mschwabmd/UMBC_DPLX_SPARK_2018/SPARK CAD Files/DPLX_A001_revE_Electrode_assm.SLDASM

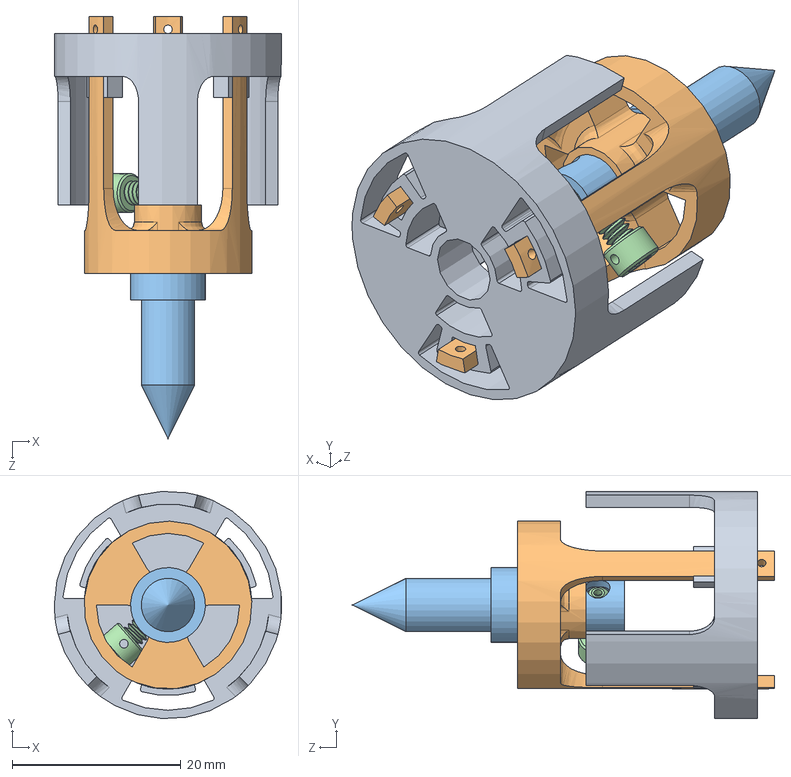
[picture p1: CAD file, 2018-07-30]
SPARK CAD Files/DPLX_A001_revE_Electrode_assm.SLDASM
27.0 x 27.0 x 50.1 mm
DPLX_P004_revD_large_outside_baffle
DPLX_P003_revB_small_inside_baffle
DPLX_P001_Electrode
DPLX_P006_BRASS SOCKET HEAD CAP SCREW
