mschwabmd/UMBC_DPLX_SPARK_2018/CAD Step Files/DPLX_A002_Lab_Version.stp

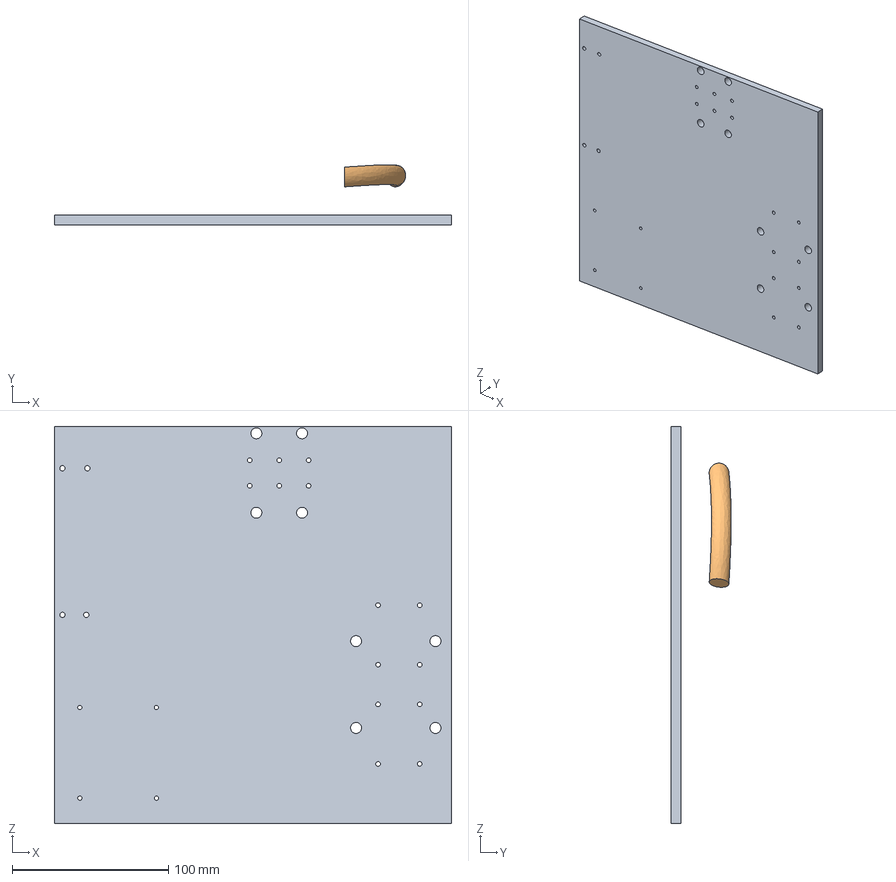
[picture p2: CAD file, 2018-07-31]
CAD Step Files/DPLX_A002_Lab_Version.stp
254.0 x 38.6 x 254.0 mm
DPLX_P013_Lab_Baseplate
Wire3
