mschwabmd/UMBC_DPLX_SPARK_2018/SPARK CAD Files/DPLX_P005_quartz_tube.SLDPRT

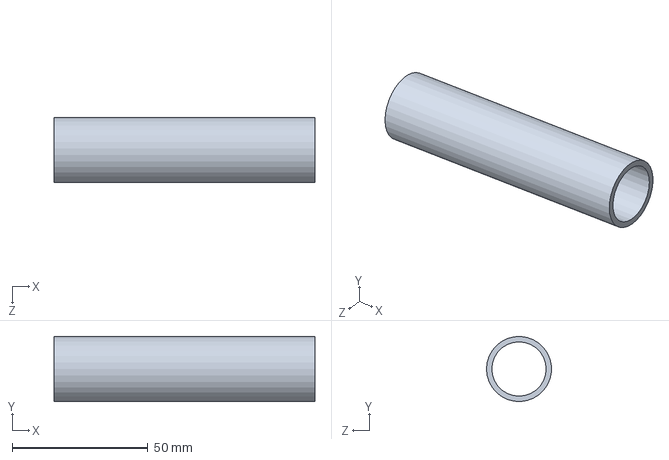
[picture p3: CAD file, 2018-07-30]
SPARK CAD Files/DPLX_P005_quartz_tube.SLDPRT
96.2 x 24.0 x 24.0 mm
