mschwabmd/UMBC_DPLX_SPARK_2018/CAD Step Files/DPLX_P019_Camera Shroud_RevA.stp

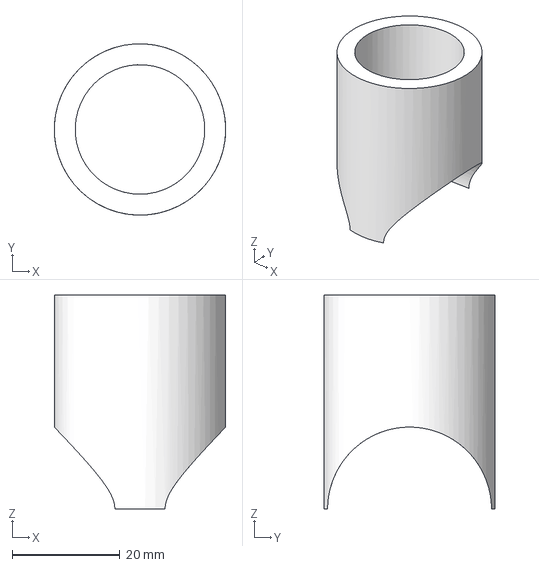
[picture p4: CAD file, 2018-07-31]
CAD Step Files/DPLX_P019_Camera Shroud_RevA.stp
31.7 x 31.7 x 39.6 mm
