mschwabmd/UMBC_DPLX_SPARK_2018/SPARK CAD Files/DPLX_P004_revD_large_outside_baffle.SLDPRT

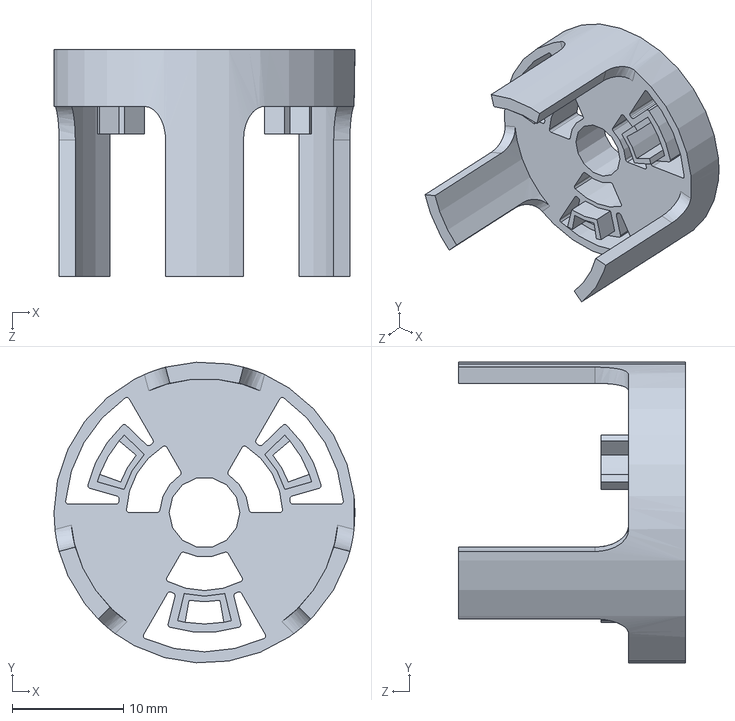
[picture p5: CAD file, 2018-07-30]
SPARK CAD Files/DPLX_P004_revD_large_outside_baffle.SLDPRT
27.0 x 27.0 x 20.3 mm
