mschwabmd/UMBC_DPLX_SPARK_2018/CAD Step Files/DPLX_P023 Spark Gap Shielding Bottom.stp

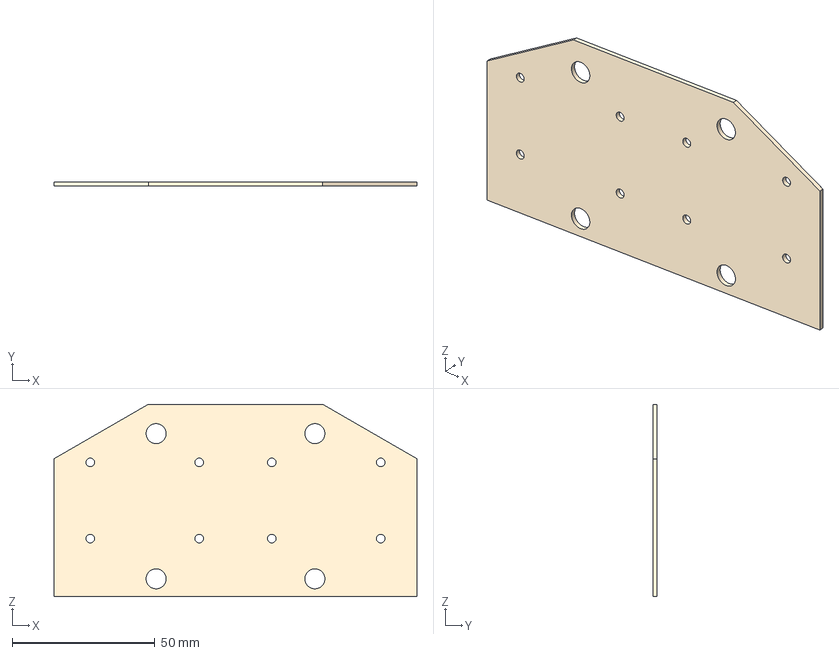
[picture p6: CAD file, 2018-07-31]
CAD Step Files/DPLX_P023 Spark Gap Shielding Bottom.stp
127.0 x 1.52 x 67.3 mm
