mschwabmd/UMBC_DPLX_SPARK_2018/SPARK CAD Files/DPLX_P020_Camera Shroud Base_RevB.stp

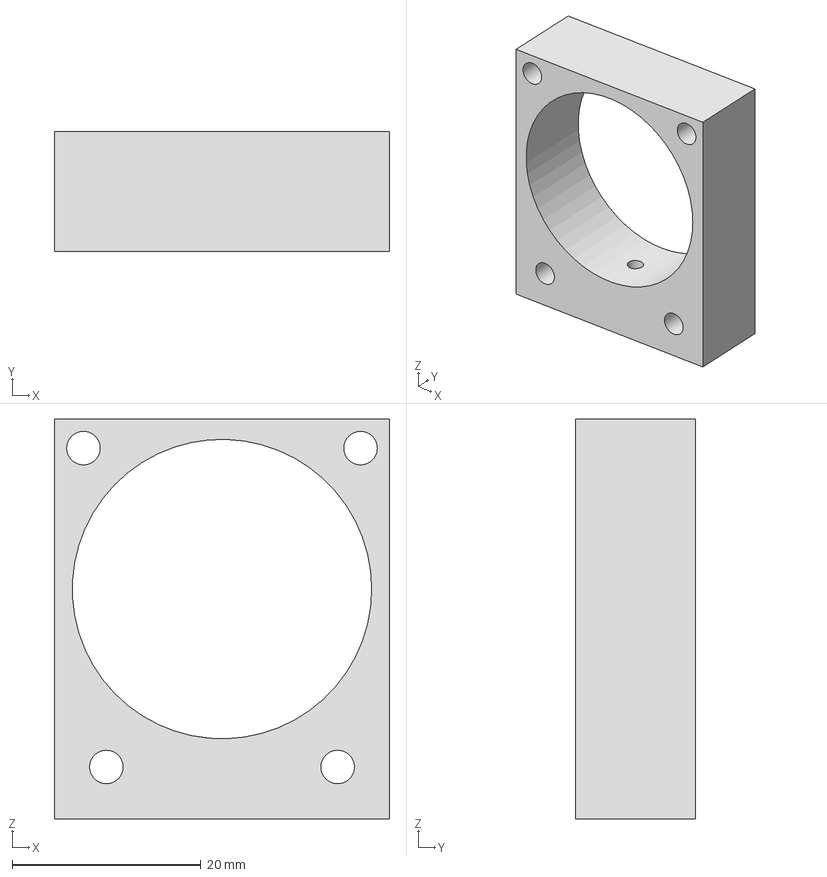
[picture p7: CAD file, 2018-07-30]
SPARK CAD Files/DPLX_P020_Camera Shroud Base_RevB.stp
35.6 x 12.7 x 42.4 mm
