mschwabmd/UMBC_DPLX_SPARK_2018/CAD Step Files/Pin dowel .0625^225-00000-000_CD.stp

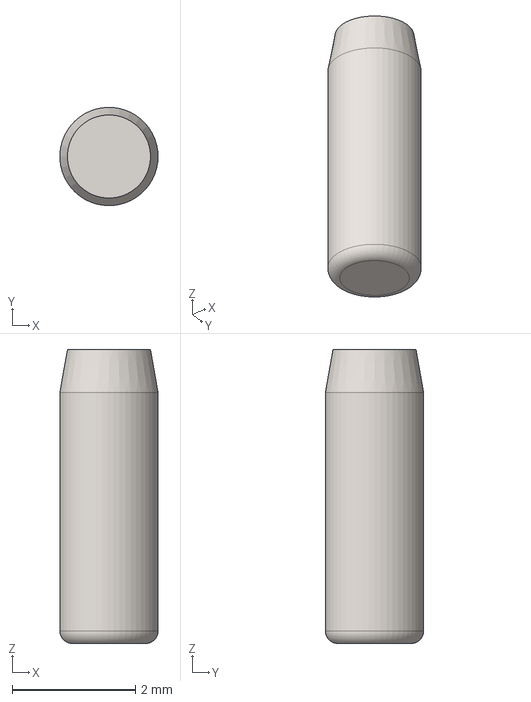
[picture p8: CAD file, 2018-07-31]
CAD Step Files/Pin dowel .0625^225-00000-000_CD.stp
1.59 x 1.59 x 4.76 mm
