mschwabmd/UMBC_DPLX_SPARK_2018/SPARK CAD Files/Ocean Optics Flame.stp

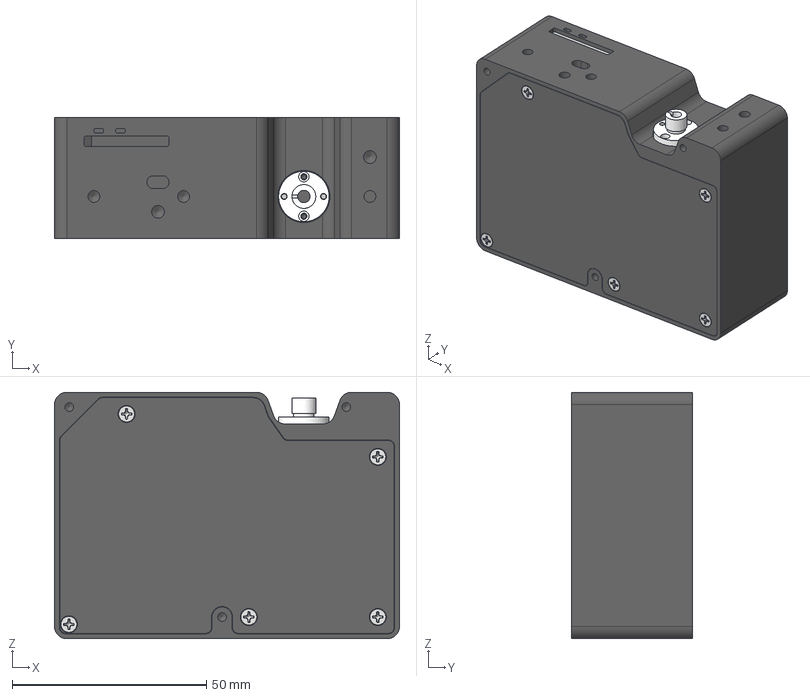
[picture p9: CAD file, 2018-07-30]
SPARK CAD Files/Ocean Optics Flame.stp
88.9 x 31.1 x 63.5 mm
Bench^225-00000-000_CD
Connector^225-00000-000_CD
Pin dowel .0625^225-00000-000_CD x 2
Cover Top^225-00000-000_CD
Cover Bottom^225-00000-000_CD
No 2 Screw^225-00000-000_CD x 11
