mschwabmd/UMBC_DPLX_SPARK_2018/CAD Step Files/Pi Wire.stp

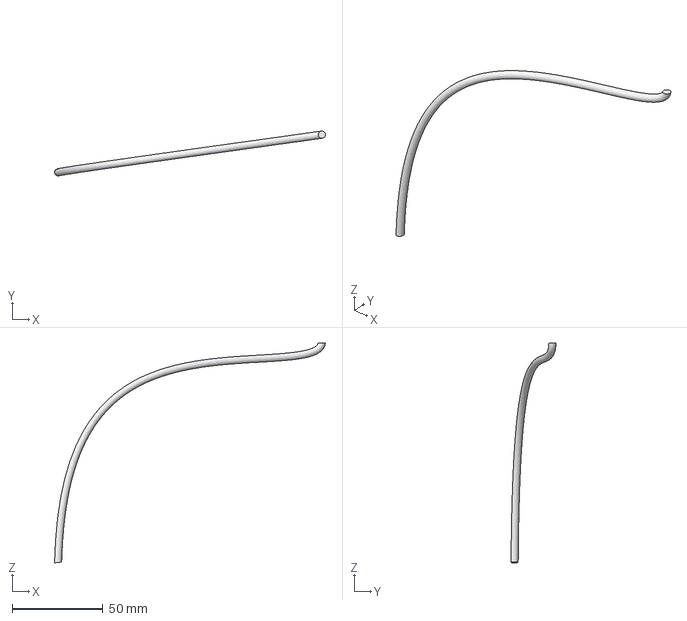
[picture p10: CAD file, 2018-07-31]
CAD Step Files/Pi Wire.stp
149.5 x 24.8 x 121.2 mm
