mschwabmd/UMBC_DPLX_SPARK_2018/CAD Step Files/DPLX_P037 USB.stp

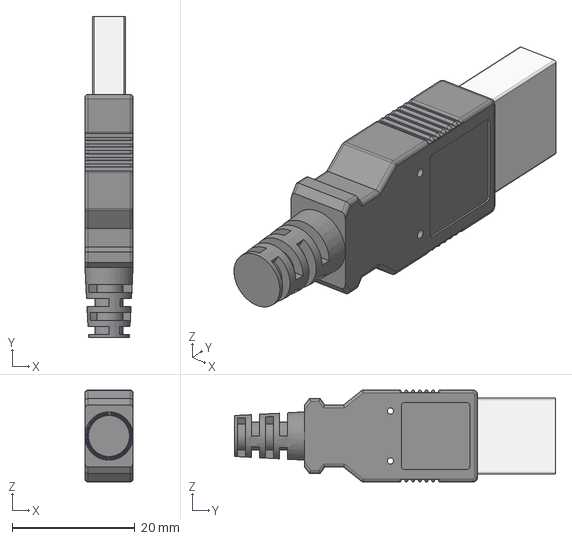
[picture p11: CAD file, 2018-07-31]
CAD Step Files/DPLX_P037 USB.stp
7.87 x 52.3 x 15.0 mm
