mschwabmd/UMBC_DPLX_SPARK_2018/CAD Step Files/DPLX_A005_Spark_Gap_Lab.stp

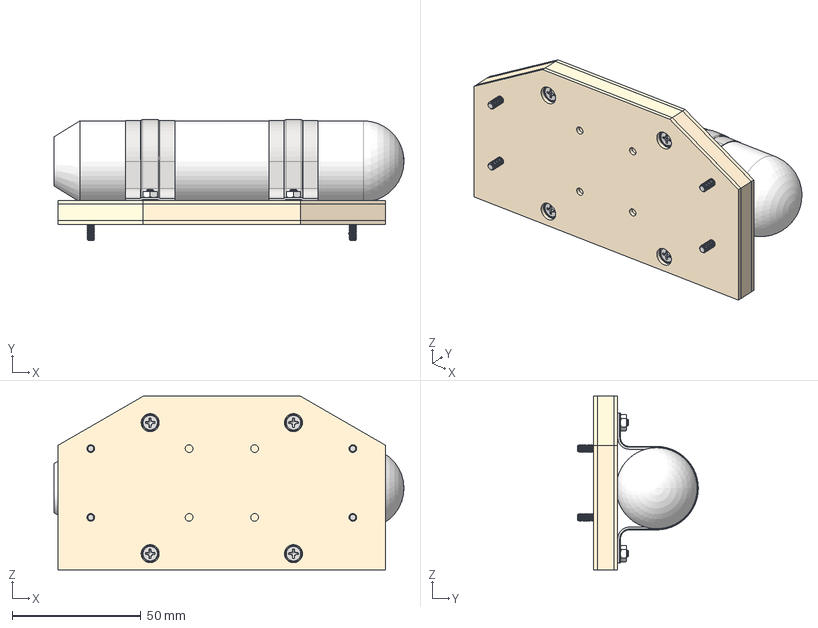
[picture p12: CAD file, 2018-07-31]
CAD Step Files/DPLX_A005_Spark_Gap_Lab.stp
135.7 x 46.8 x 67.3 mm
DPLX_P023 Spark Gap Shielding Bottom
DPLX_P022 Spark Gap Shielding Top
DPLX_P035 Spark Gap Shielding Middle
92010A787_PASSIVATED 18-8 SS PHILLIPS FLAT HEAD SCREW x 4
92010A122_METRIC 18-8 SS FLAT HEAD PHIL MACHINE SCREW x 4
9429T360_STEEL CLAMP x 2
DPLX_P025_Quartz_Tube
DPLX_P007_Wire_Mesh_Sleeve_Spark_Gap
DPLX_P033_SG_Viton rubber Cover
DPLX_P015_Foil_Wrap_SG
DPLX_P001_Electrode x 2
DPLX_P006_BRASS SOCKET HEAD CAP SCREW x 2
DPLX_P003_small_inside_baffle_RevB x 2
DPLX_P004_revD_large_outside_baffle x 2
91828A211_TYPE 18-8 STAINLESS STEEL HEX NUT x 4
DPLX_P010_Wire_Mesh_reducer_Spark_Gap
