mschwabmd/UMBC_DPLX_SPARK_2018/SPARK CAD Files/DPLX_P003_revC_small_inside_baffle.SLDPRT

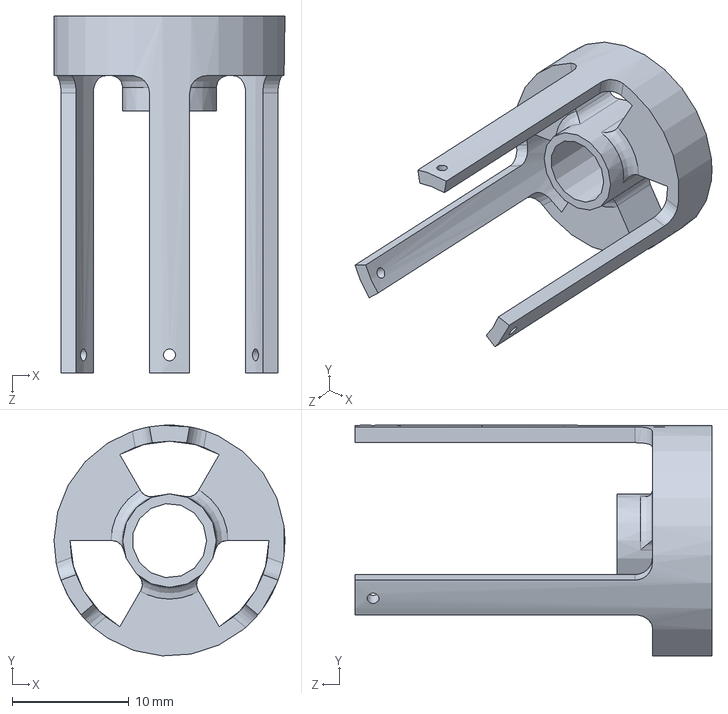
[picture p13: CAD file, 2018-07-30]
SPARK CAD Files/DPLX_P003_revC_small_inside_baffle.SLDPRT
19.8 x 19.7 x 30.5 mm
