mschwabmd/UMBC_DPLX_SPARK_2018/SPARK CAD Files/DPLX_P001_Electrode.SLDPRT

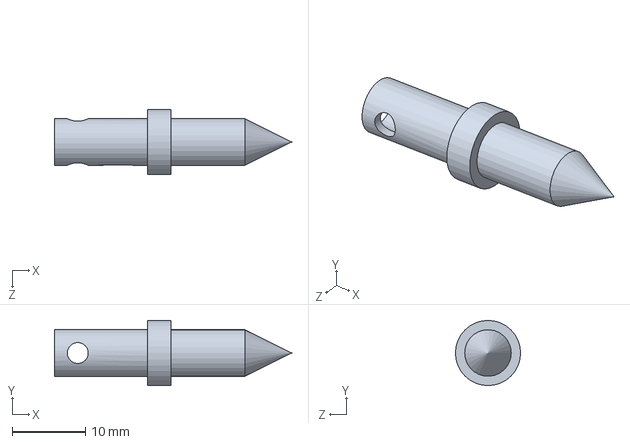
[picture p15: CAD file, 2018-07-30]
SPARK CAD Files/DPLX_P001_Electrode.SLDPRT
32.3 x 8.89 x 8.89 mm
