mschwabmd/UMBC_DPLX_SPARK_2018/CAD Step Files/DPLX_P032_VIPE Insulation Middle.stp

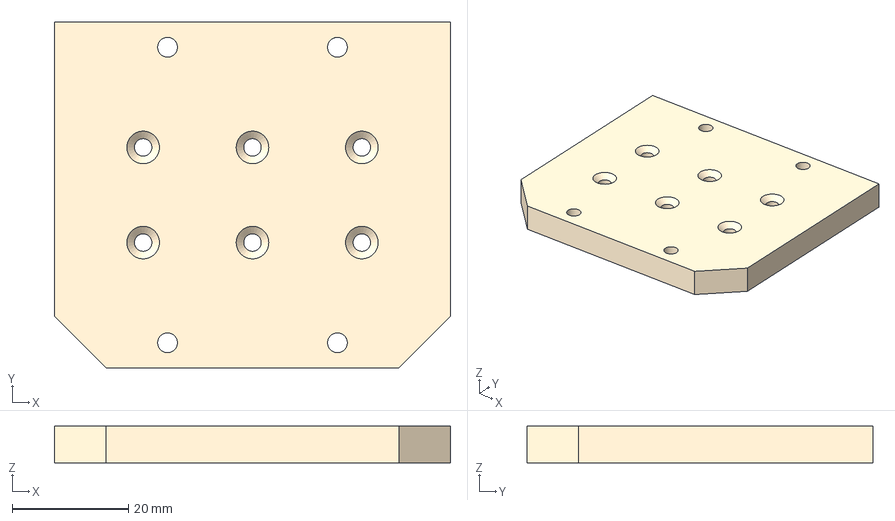
[picture p16: CAD file, 2018-07-31]
CAD Step Files/DPLX_P032_VIPE Insulation Middle.stp
68.1 x 59.5 x 6.35 mm
