mschwabmd/UMBC_DPLX_SPARK_2018/CAD Step Files/DPLX_P026_VIPE _Transformer.stp

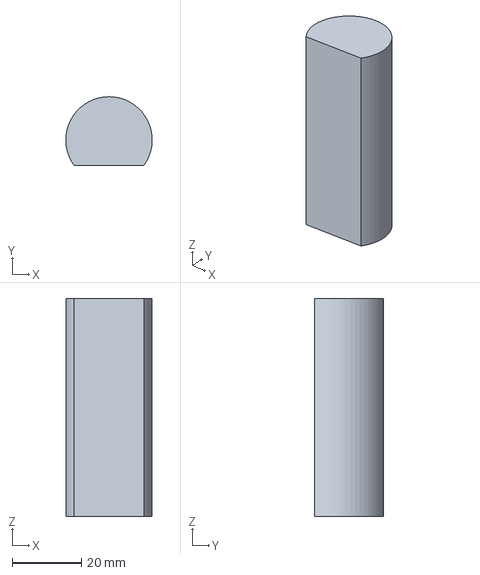
[picture p17: CAD file, 2018-07-31]
CAD Step Files/DPLX_P026_VIPE _Transformer.stp
25.0 x 19.8 x 63.0 mm
