mschwabmd/UMBC_DPLX_SPARK_2018/CAD Step Files/Cover Bottom^225-00000-000_CD.stp

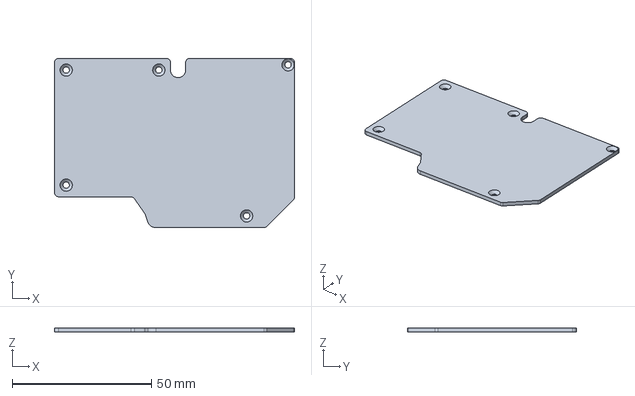
[picture p19: CAD file, 2018-07-31]
CAD Step Files/Cover Bottom^225-00000-000_CD.stp
86.1 x 60.7 x 1.52 mm
