mschwabmd/UMBC_DPLX_SPARK_2018/CAD Step Files/DPLX_P008_Wire_Mesh_Sleeve_Trans.stp

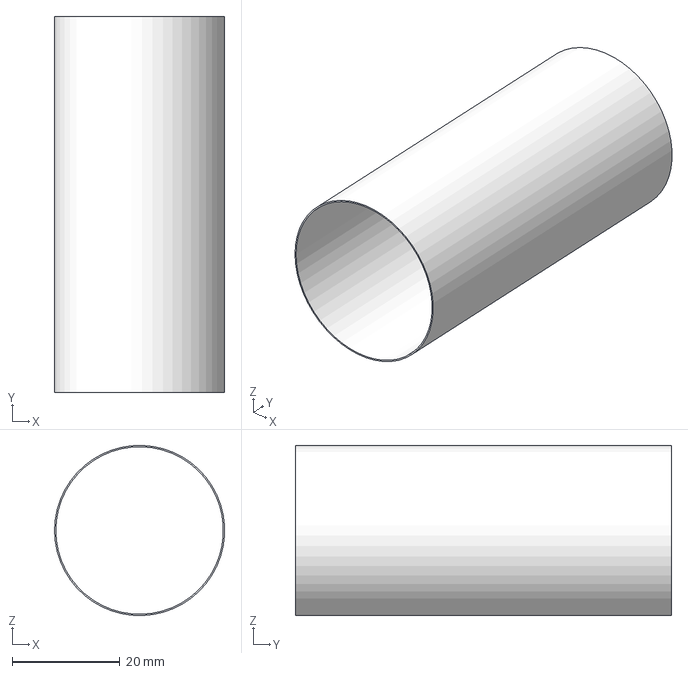
[picture p20: CAD file, 2018-07-31]
CAD Step Files/DPLX_P008_Wire_Mesh_Sleeve_Trans.stp
31.6 x 70.0 x 31.6 mm
