mschwabmd/UMBC_DPLX_SPARK_2018/CAD Step Files/DPLX_P013_Lab_Baseplate.stp

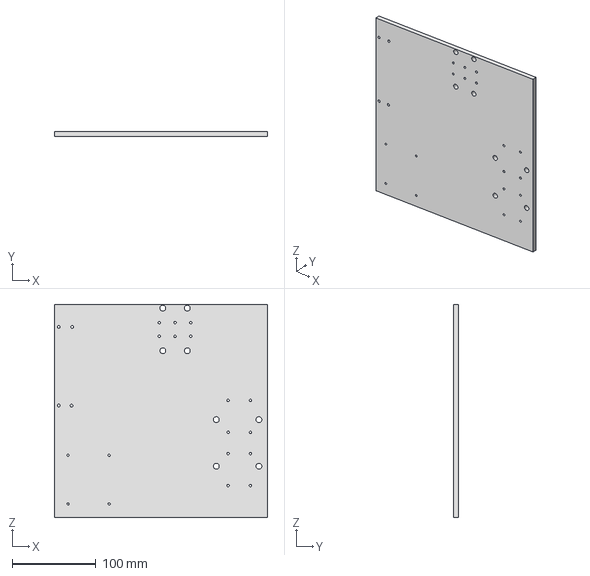
[picture p21: CAD file, 2018-07-31]
CAD Step Files/DPLX_P013_Lab_Baseplate.stp
254.0 x 6.35 x 254.0 mm
