mschwabmd/UMBC_DPLX_SPARK_2018/CAD Step Files/DPLX_P034_RPS VIPE Viton Insualtion.stp

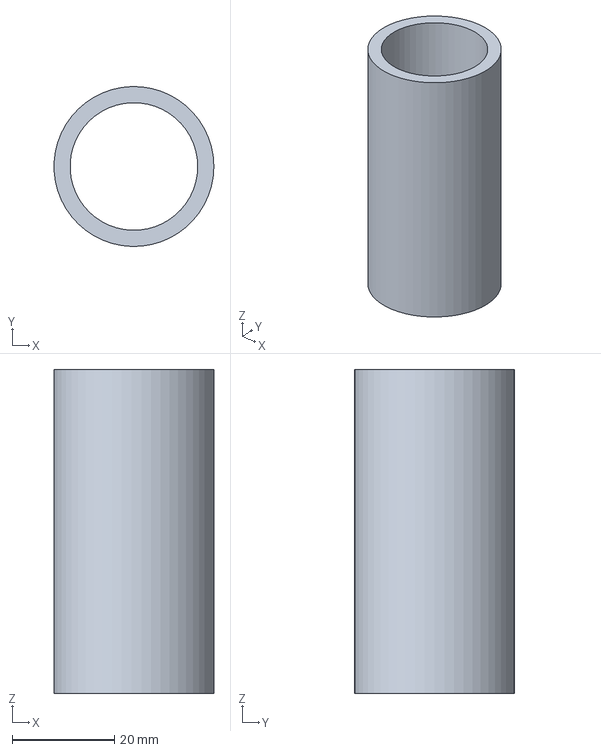
[picture p22: CAD file, 2018-07-31]
CAD Step Files/DPLX_P034_RPS VIPE Viton Insualtion.stp
31.3 x 31.3 x 63.5 mm
