mschwabmd/UMBC_DPLX_SPARK_2018/CAD Step Files/Wire to Spark Gap.stp

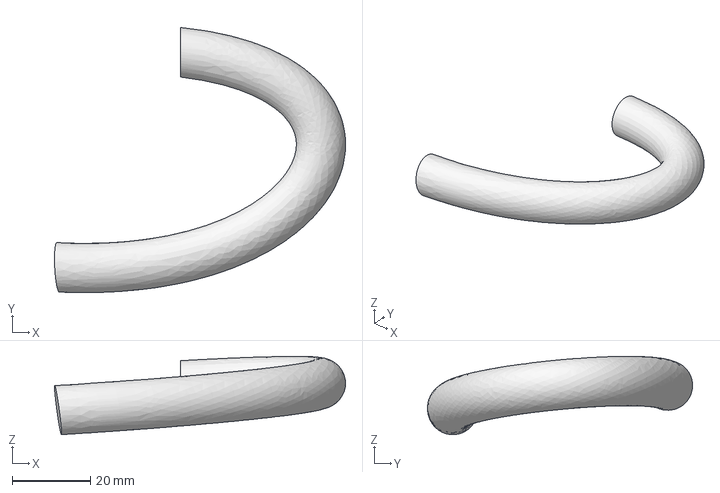
[picture p23: CAD file, 2018-07-31]
CAD Step Files/Wire to Spark Gap.stp
74.5 x 67.9 x 20.1 mm
