mschwabmd/UMBC_DPLX_SPARK_2018/CAD Step Files/DPLX_P003_small_inside_baffle_RevB.stp

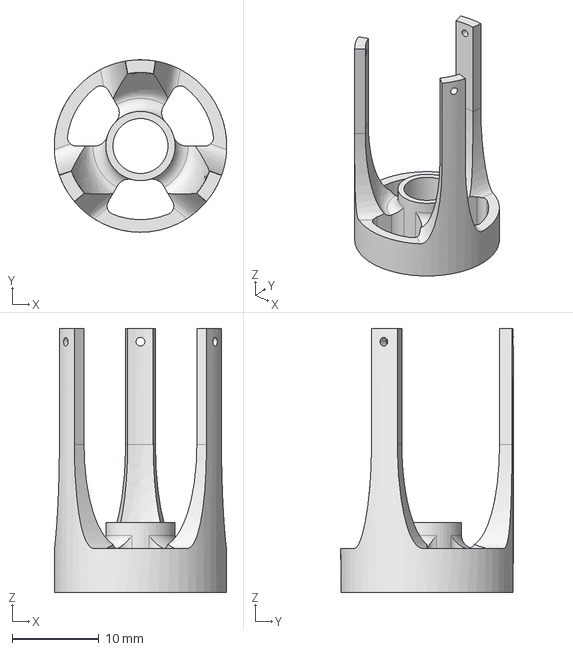
[picture p24: CAD file, 2018-07-31]
CAD Step Files/DPLX_P003_small_inside_baffle_RevB.stp
19.9 x 19.9 x 30.5 mm
