mschwabmd/UMBC_DPLX_SPARK_2018/CAD Step Files/DPLX_P030_VIPE Insulation Bottom.stp

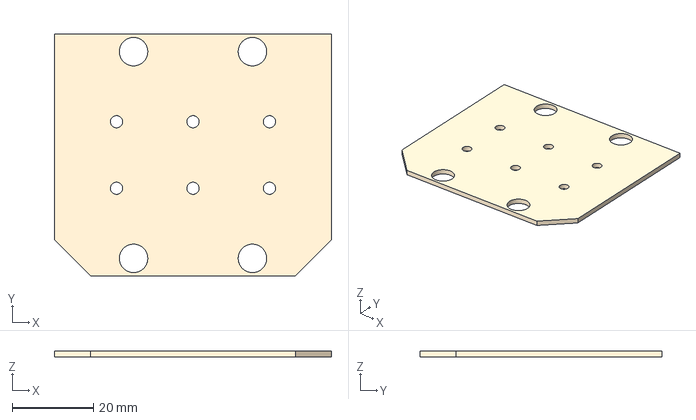
[picture p25: CAD file, 2018-07-31]
CAD Step Files/DPLX_P030_VIPE Insulation Bottom.stp
68.1 x 59.5 x 1.52 mm
