mschwabmd/UMBC_DPLX_SPARK_2018/CAD Step Files/SSL Base Plate.stp

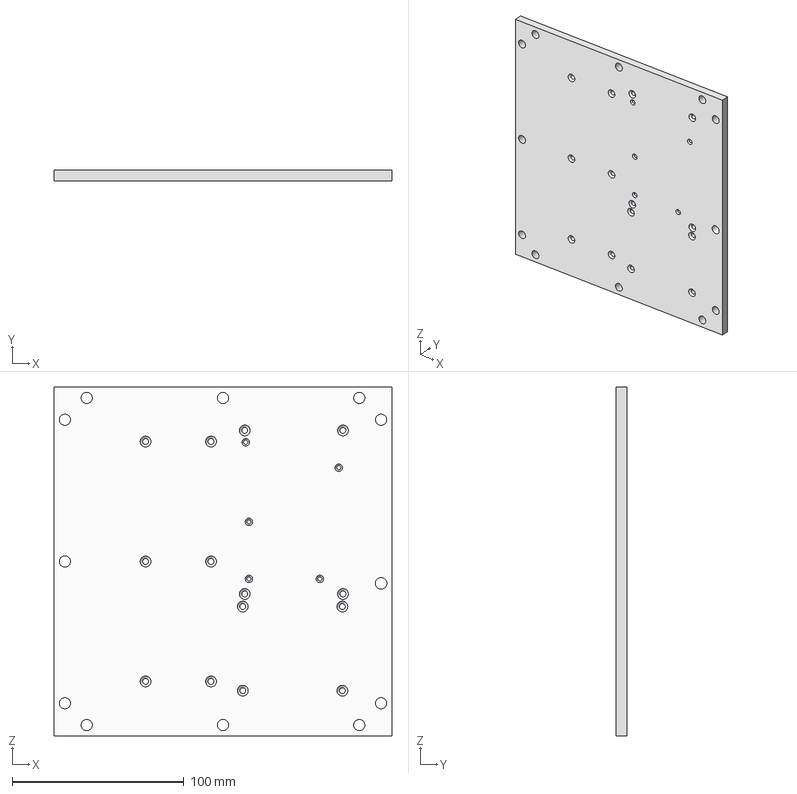
[picture p26: CAD file, 2018-07-31]
CAD Step Files/SSL Base Plate.stp
196.8 x 6.35 x 203.2 mm
