mschwabmd/UMBC_DPLX_SPARK_2018/CAD Step Files/wire4.stp

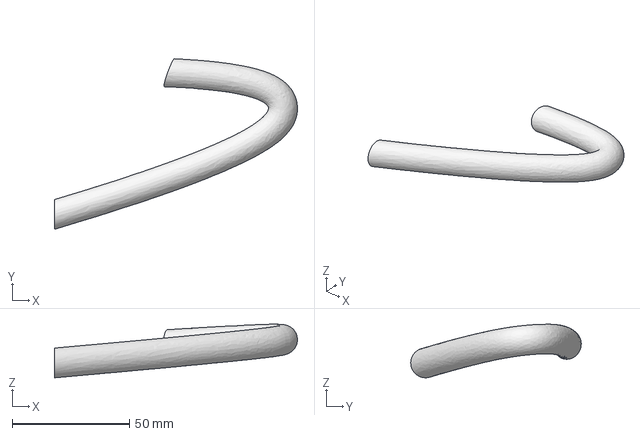
[picture p27: CAD file, 2018-07-31]
CAD Step Files/wire4.stp
103.5 x 72.6 x 22.9 mm
