mschwabmd/UMBC_DPLX_SPARK_2018/CAD Step Files/DPLX_P025_Quartz_Tube.stp

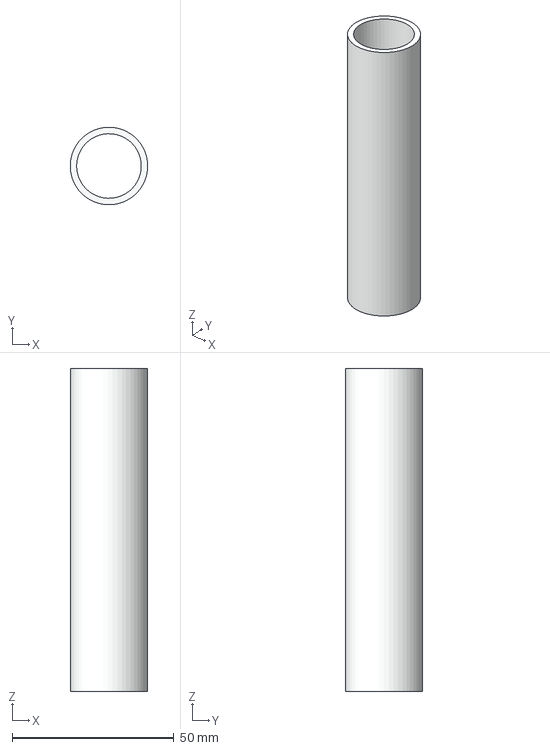
[picture p28: CAD file, 2018-07-31]
CAD Step Files/DPLX_P025_Quartz_Tube.stp
24.0 x 24.0 x 100.0 mm
