mschwabmd/UMBC_DPLX_SPARK_2018/CAD Step Files/DPLX_P015_Foil_Wrap_SG.stp

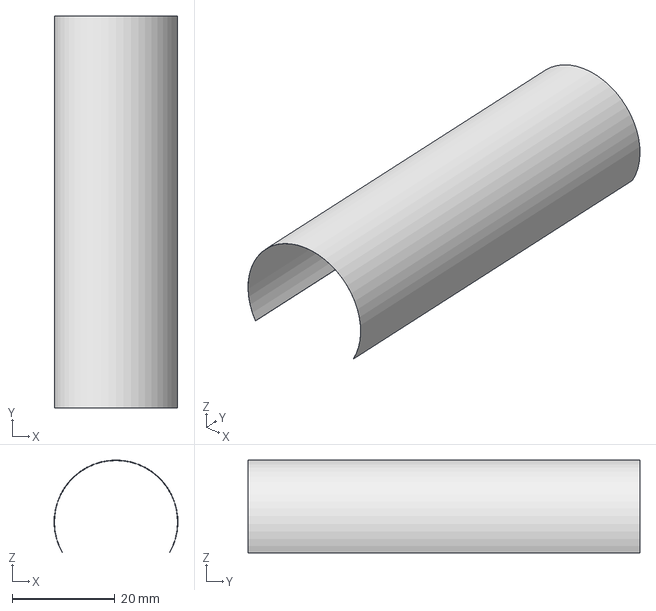
[picture p29: CAD file, 2018-07-31]
CAD Step Files/DPLX_P015_Foil_Wrap_SG.stp
24.0 x 76.2 x 18.0 mm
