mschwabmd/UMBC_DPLX_SPARK_2018/CAD Step Files/DPLX_P021_Standoff_Rasp_pie_Lab_payload_sv.stp

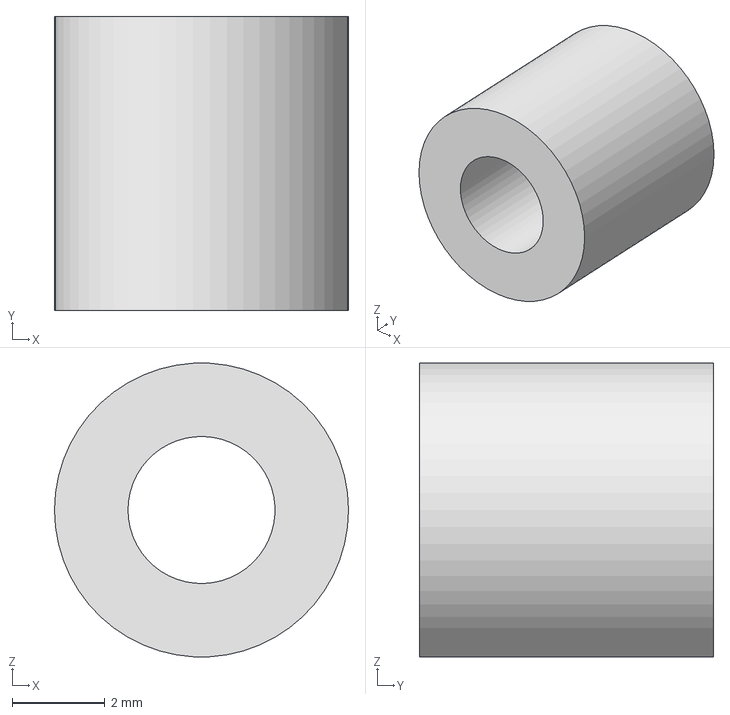
[picture p30: CAD file, 2018-07-31]
CAD Step Files/DPLX_P021_Standoff_Rasp_pie_Lab_payload_sv.stp
6.35 x 6.35 x 6.34 mm
