mschwabmd/UMBC_DPLX_SPARK_2018/CAD Step Files/DPLX_P017_.5in _Standoff_smallplate.stp

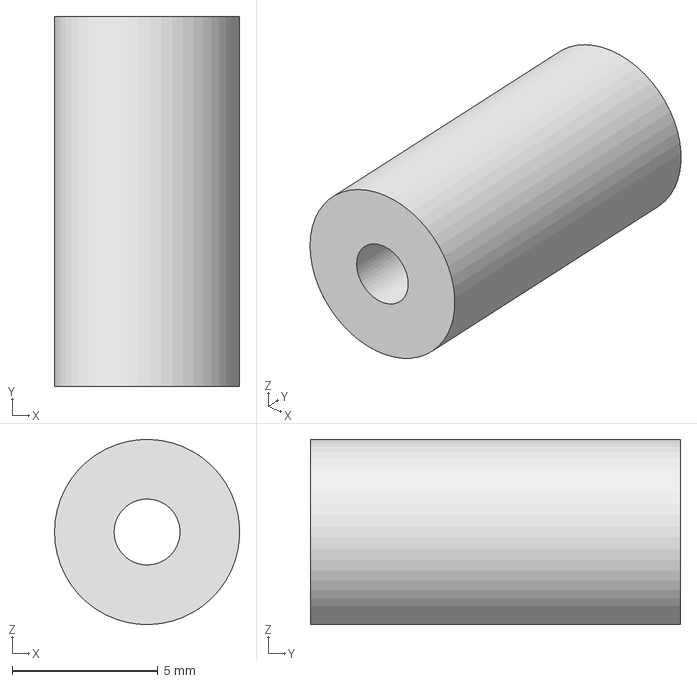
[picture p31: CAD file, 2018-07-31]
CAD Step Files/DPLX_P017_.5in _Standoff_smallplate.stp
6.34 x 12.7 x 6.35 mm
