mschwabmd/UMBC_DPLX_SPARK_2018/CAD Step Files/DPLX_P038 Micro USB.stp

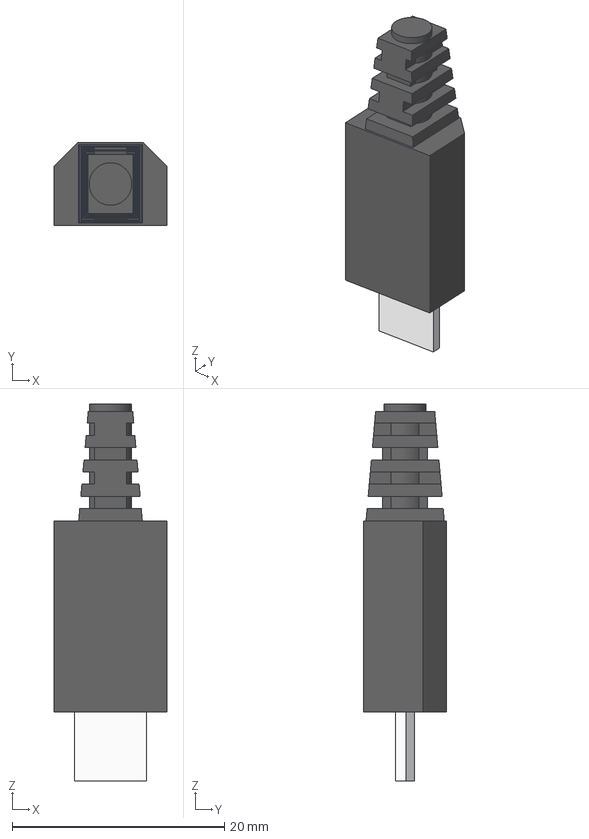
[picture p32: CAD file, 2018-07-31]
CAD Step Files/DPLX_P038 Micro USB.stp
10.6 x 7.80 x 35.5 mm
