mschwabmd/UMBC_DPLX_SPARK_2018/CAD Step Files/Wire3.stp

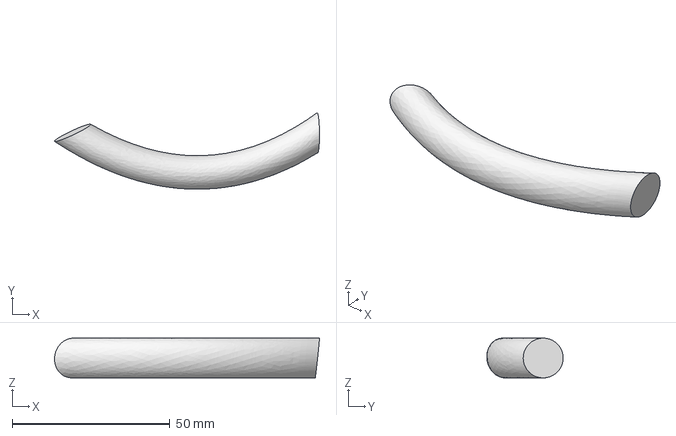
[picture p33: CAD file, 2018-07-31]
CAD Step Files/Wire3.stp
84.1 x 24.3 x 12.6 mm
