mschwabmd/UMBC_DPLX_SPARK_2018/CAD Step Files/Connector^225-00000-000_CD.stp

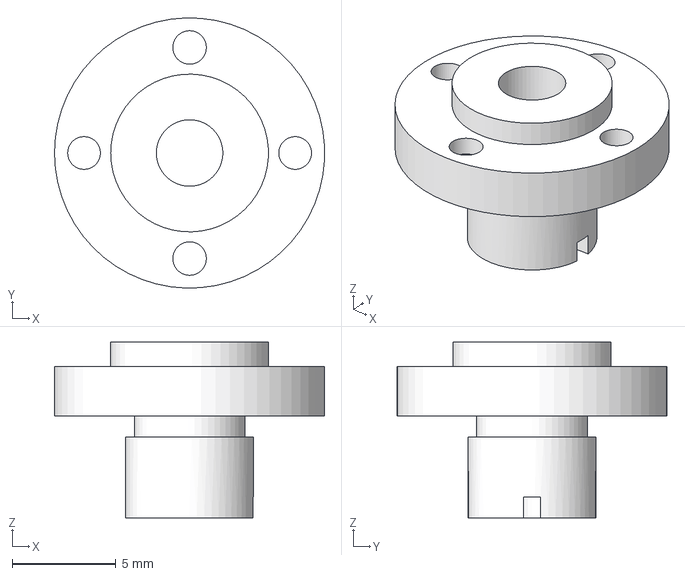
[picture p34: CAD file, 2018-07-31]
CAD Step Files/Connector^225-00000-000_CD.stp
13.0 x 13.0 x 8.46 mm
