mschwabmd/UMBC_DPLX_SPARK_2018/CAD Step Files/DPLX_P020_Camera Shroud Base_RevB.stp

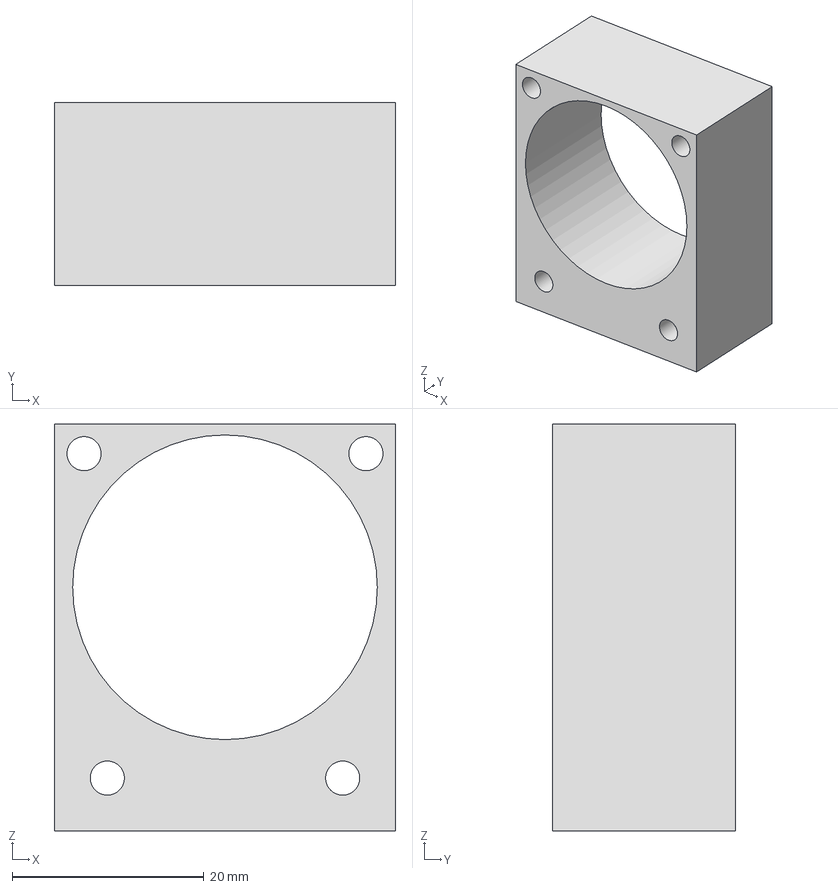
[picture p35: CAD file, 2018-07-31]
CAD Step Files/DPLX_P020_Camera Shroud Base_RevB.stp
35.6 x 19.0 x 42.4 mm
