mschwabmd/UMBC_DPLX_SPARK_2018/CAD Step Files/DPLX_P018_Crude_Battery_Placeholder_Smalltestmod.stp

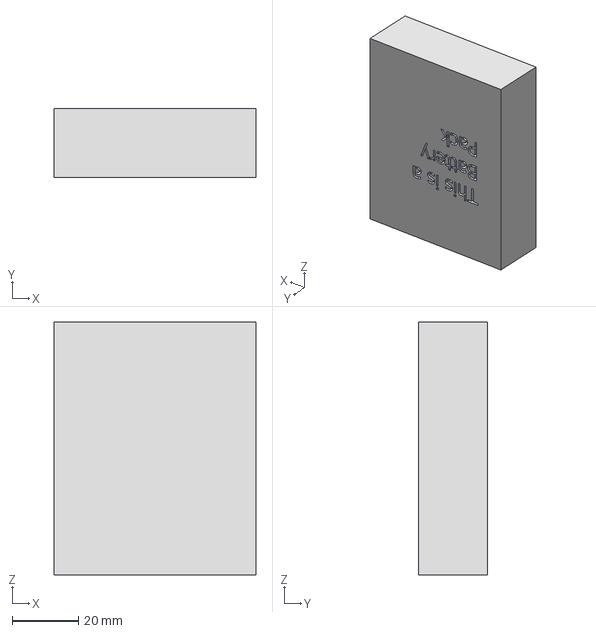
[picture p36: CAD file, 2018-07-31]
CAD Step Files/DPLX_P018_Crude_Battery_Placeholder_Smalltestmod.stp
60.7 x 20.8 x 76.2 mm
