mschwabmd/UMBC_DPLX_SPARK_2018/CAD Step Files/DPLX_P011_Wire_Mesh_90_Elbow.stp

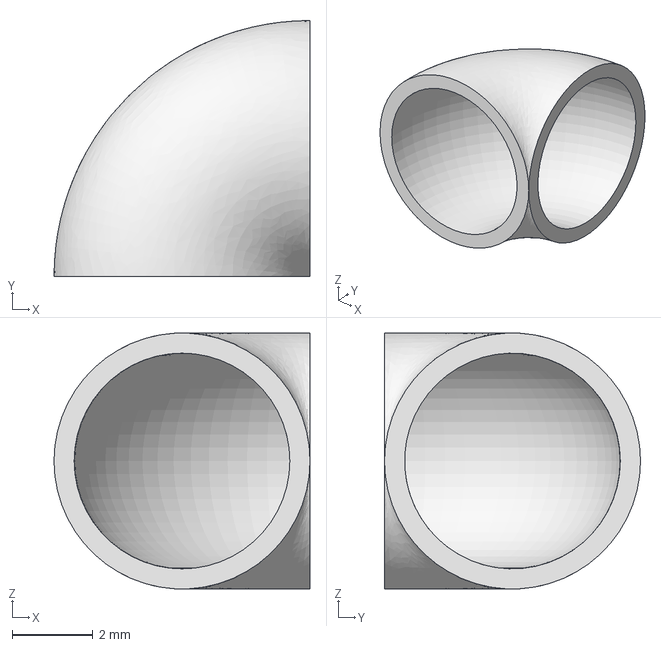
[picture p37: CAD file, 2018-07-31]
CAD Step Files/DPLX_P011_Wire_Mesh_90_Elbow.stp
6.35 x 6.35 x 6.35 mm
