mschwabmd/UMBC_DPLX_SPARK_2018/CAD Step Files/DPLX_P009_Wire_Mesh_reducer_Trans.stp

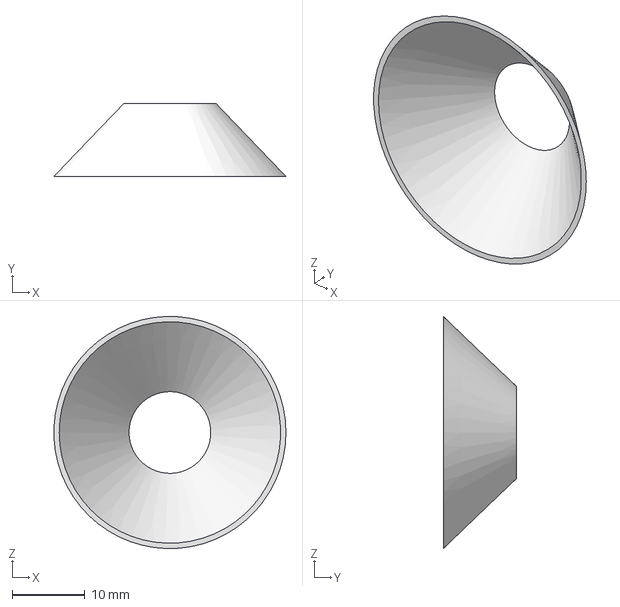
[picture p38: CAD file, 2018-07-31]
CAD Step Files/DPLX_P009_Wire_Mesh_reducer_Trans.stp
31.9 x 10.0 x 31.9 mm
