mschwabmd/UMBC_DPLX_SPARK_2018/CAD Step Files/DPLX_P033_SG_Viton rubber Cover.stp

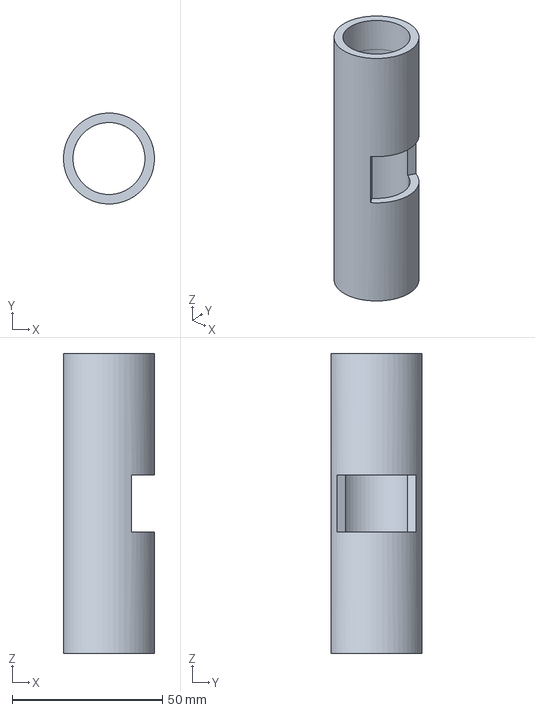
[picture p39: CAD file, 2018-07-31]
CAD Step Files/DPLX_P033_SG_Viton rubber Cover.stp
30.3 x 30.3 x 100.0 mm
