mschwabmd/UMBC_DPLX_SPARK_2018/CAD Step Files/usb Wire.stp

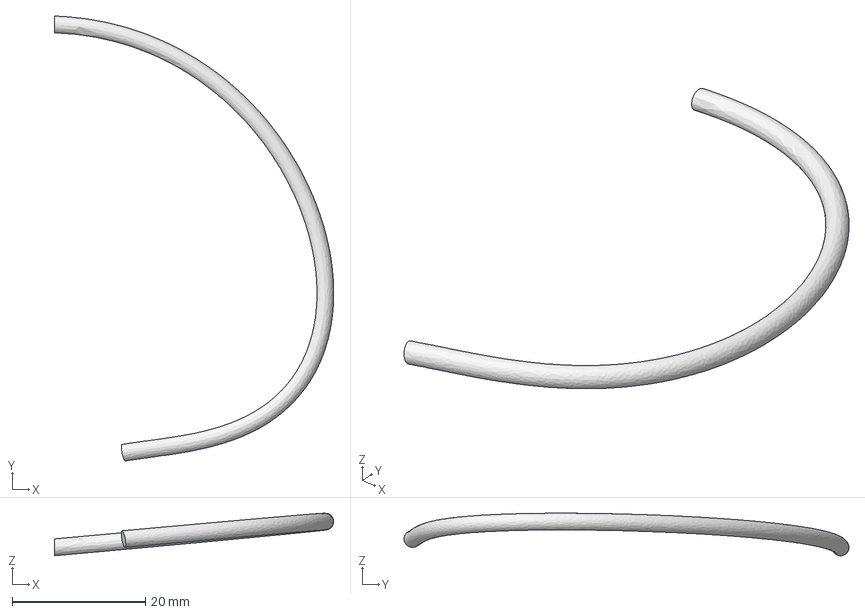
[picture p40: CAD file, 2018-07-31]
CAD Step Files/usb Wire.stp
41.9 x 66.8 x 6.40 mm
