mschwabmd/UMBC_DPLX_SPARK_2018/CAD Step Files/DPLX_P016_Spark_Gap_Camera_Shroud.stp

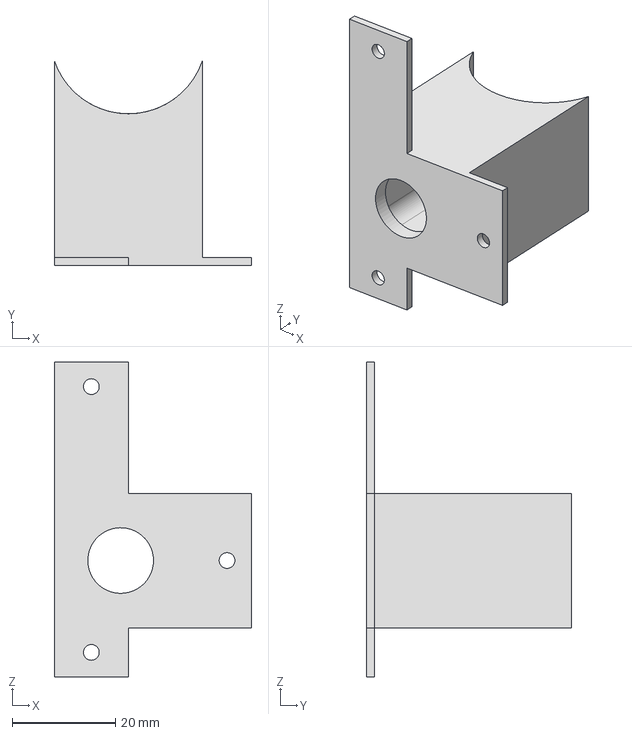
[picture p41: CAD file, 2018-07-31]
CAD Step Files/DPLX_P016_Spark_Gap_Camera_Shroud.stp
38.2 x 39.6 x 60.9 mm
