mschwabmd/UMBC_DPLX_SPARK_2018/CAD Step Files/DPLX_P012_Rubber_Insert_Transformer.stp

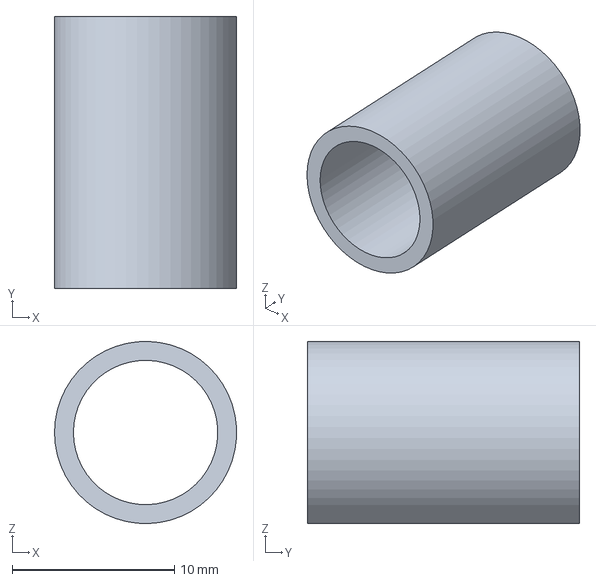
[picture p42: CAD file, 2018-07-31]
CAD Step Files/DPLX_P012_Rubber_Insert_Transformer.stp
11.2 x 16.8 x 11.2 mm
