mschwabmd/UMBC_DPLX_SPARK_2018/CAD Step Files/DPLX_A004_VIPE_Lab.stp

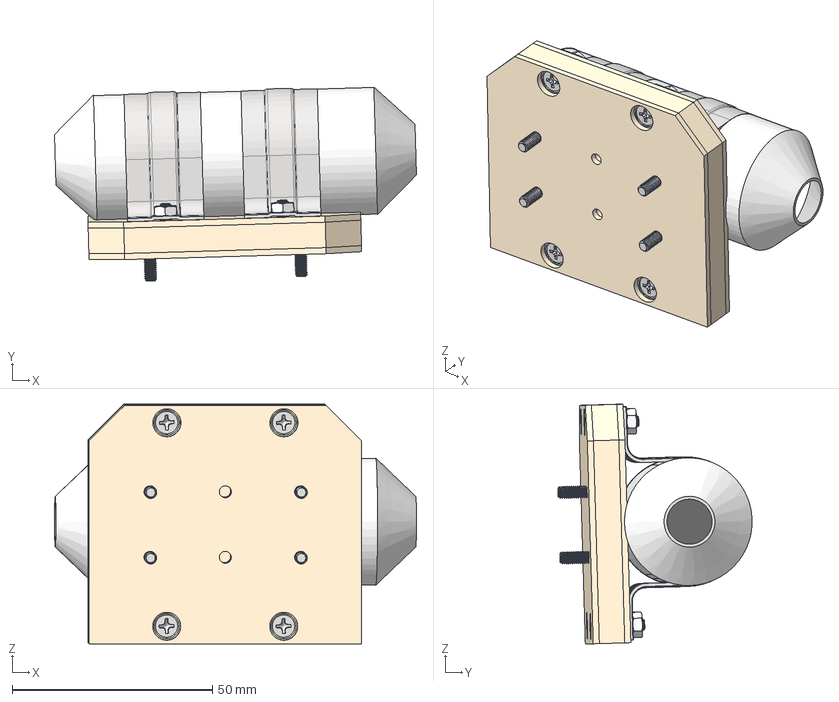
[picture p43: CAD file, 2018-07-31]
CAD Step Files/DPLX_A004_VIPE_Lab.stp
90.3 x 48.4 x 59.8 mm
DPLX_P030_VIPE Insulation Bottom
DPLX_P031_VIPE Insulation Top
DPLX_P032_VIPE Insulation Middle
92010A787_PASSIVATED 18-8 SS PHILLIPS FLAT HEAD SCREW x 4
92010A122_METRIC 18-8 SS FLAT HEAD PHIL MACHINE SCREW x 4
9429T360_STEEL CLAMP x 2
DPLX_P034_RPS VIPE Viton Insualtion
DPLX_P026_VIPE _Transformer
DPLX_P008_Wire_Mesh_Sleeve_Trans
DPLX_P009_Wire_Mesh_reducer_Trans x 2
91828A211_TYPE 18-8 STAINLESS STEEL HEX NUT x 4
