mschwabmd/UMBC_DPLX_SPARK_2018/CAD Step Files/DPLX_P007_Wire_Mesh_Sleeve_Spark_Gap.stp

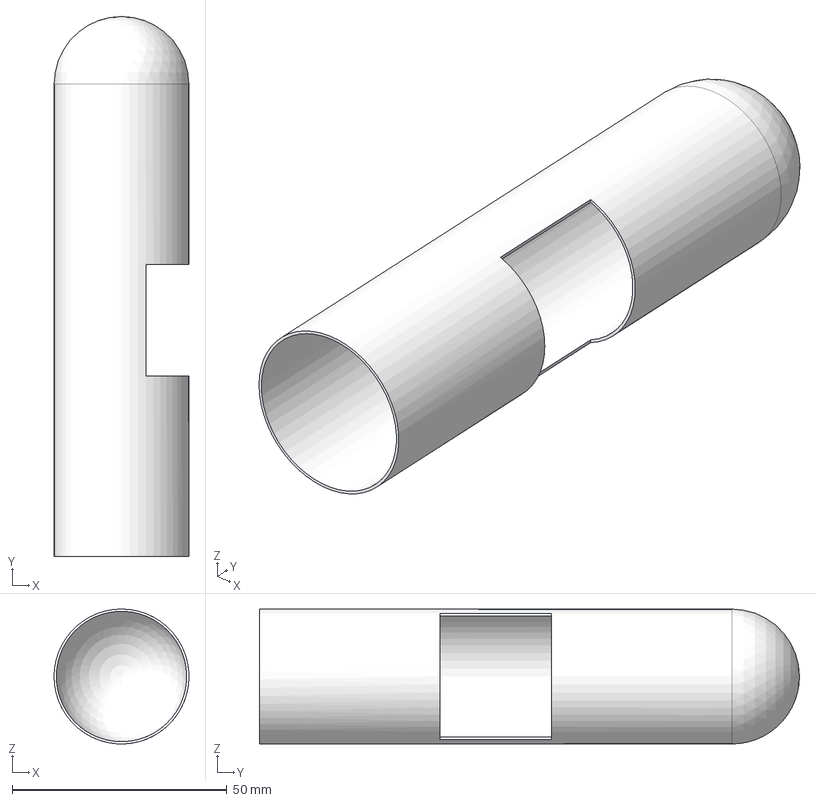
[picture p44: CAD file, 2018-07-31]
CAD Step Files/DPLX_P007_Wire_Mesh_Sleeve_Spark_Gap.stp
31.4 x 125.7 x 31.4 mm
