mschwabmd/UMBC_DPLX_SPARK_2018/CAD Step Files/DPLX_P010_Wire_Mesh_reducer_Spark_Gap.stp

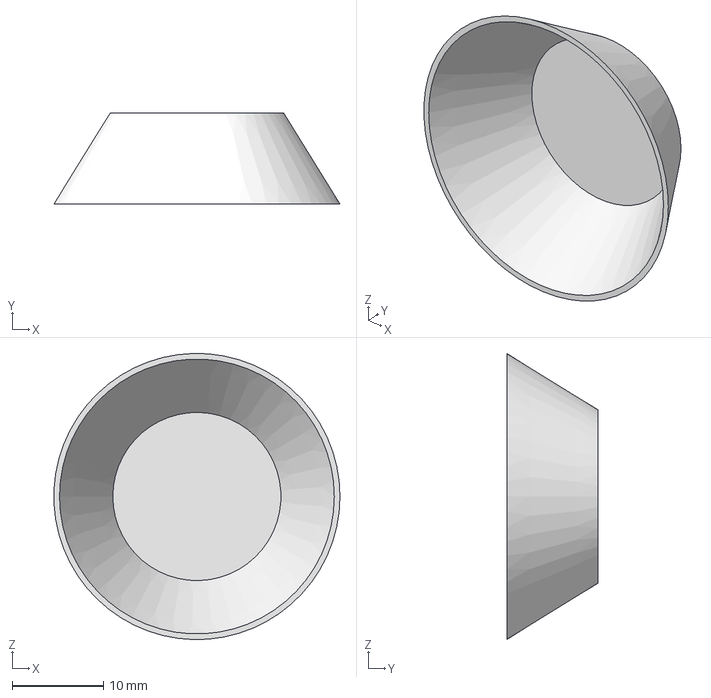
[picture p45: CAD file, 2018-07-31]
CAD Step Files/DPLX_P010_Wire_Mesh_reducer_Spark_Gap.stp
31.4 x 10.0 x 31.4 mm
