mschwabmd/UMBC_DPLX_SPARK_2018/CAD Step Files/DPLX_P035 Spark Gap Shielding Middle.stp

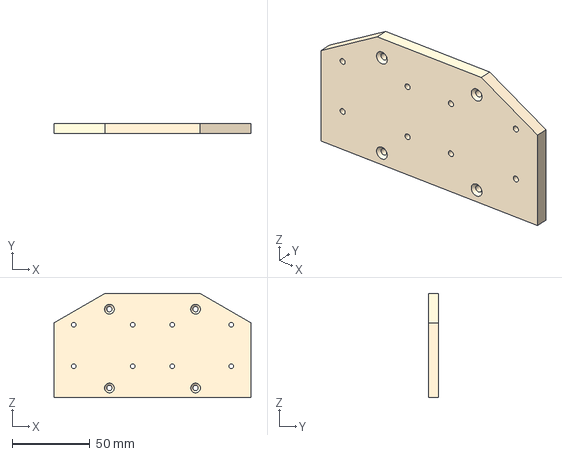
[picture p46: CAD file, 2018-07-31]
CAD Step Files/DPLX_P035 Spark Gap Shielding Middle.stp
127.0 x 6.35 x 67.3 mm
