mschwabmd/UMBC_DPLX_SPARK_2018/CAD Step Files/DPLX_A001_revE_Electrode_assmMJS.stp

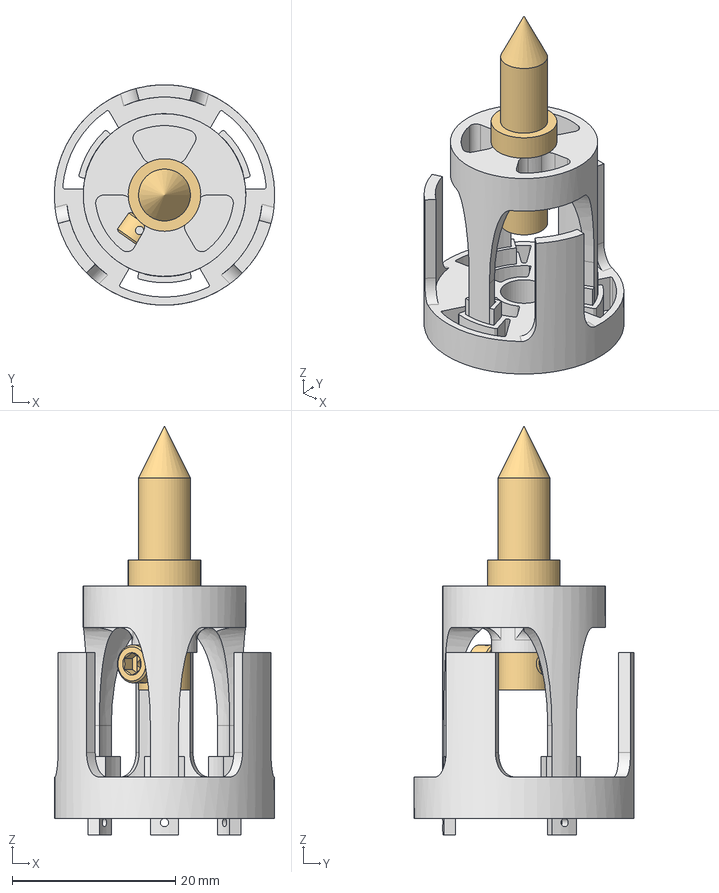
[picture p47: CAD file, 2018-07-31]
CAD Step Files/DPLX_A001_revE_Electrode_assmMJS.stp
27.0 x 27.0 x 50.1 mm
DPLX_P001_Electrode
DPLX_P006_BRASS SOCKET HEAD CAP SCREW
DPLX_P003_small_inside_baffle_RevB
DPLX_P004_revD_large_outside_baffle
