mschwabmd/UMBC_DPLX_SPARK_2018/CAD Step Files/DPLX_P014_Lab_Baseplate_Small_PV.stp

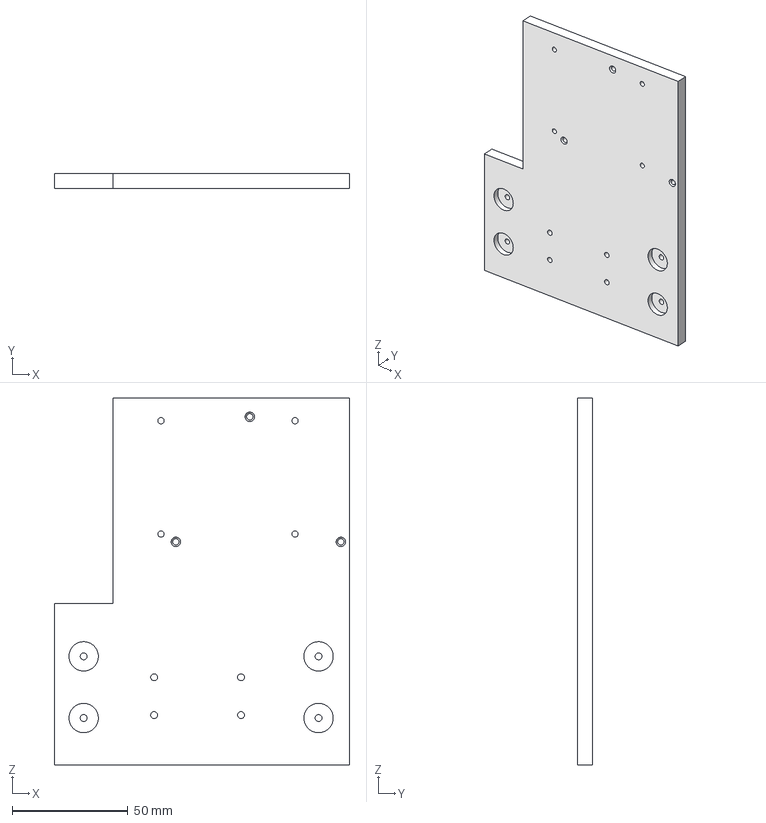
[picture p48: CAD file, 2018-07-31]
CAD Step Files/DPLX_P014_Lab_Baseplate_Small_PV.stp
127.8 x 6.35 x 158.8 mm
