mschwabmd/UMBC_DPLX_SPARK_2018/CAD Step Files/DPLX_P036 mini USB.stp

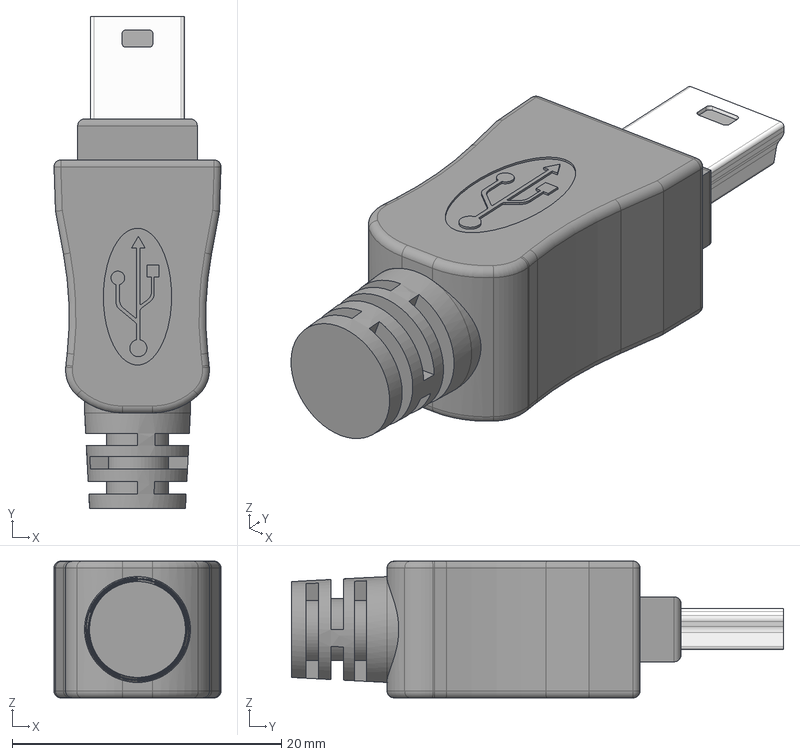
[picture p50: CAD file, 2018-07-31]
CAD Step Files/DPLX_P036 mini USB.stp
12.4 x 36.6 x 10.2 mm
