mschwabmd/UMBC_DPLX_SPARK_2018/CAD Step Files/Wire to Power.stp

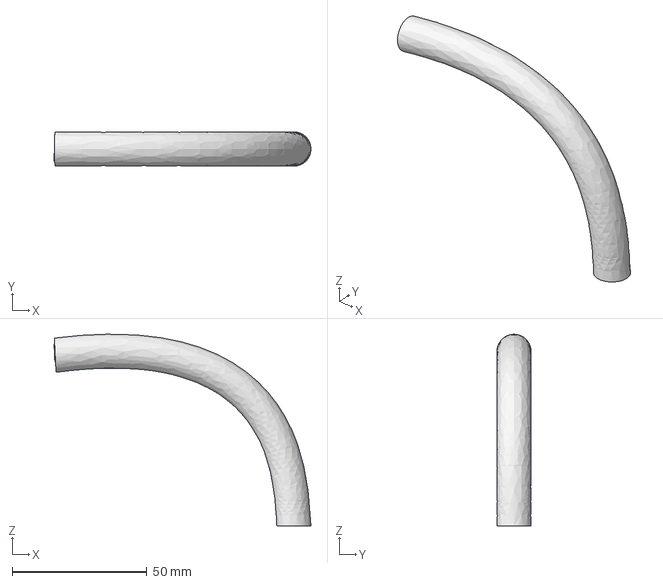
[picture p51: CAD file, 2018-07-31]
CAD Step Files/Wire to Power.stp
95.3 x 12.7 x 71.0 mm
