mschwabmd/UMBC_DPLX_SPARK_2018/(list of files, cad)

Other CAD files:
Mechanical Drawings/DPLX_P021_Standoff_Rasp_pie_Lab_payload_sv.dwg
Mechanical Drawings/DPLX_P003_revB_small_inside_baffle.dwg
Mechanical Drawings/DPLX_P015_Foil_Wrap_SG.dwg
Mechanical Drawings/DPLX_P022_Spark Gap Shielding Top.dwg
Mechanical Drawings/DPLX_P033_SG_Viton rubber Cover.dwg
Mechanical Drawings/DPLX_P035_Spark Gap Shielding Middle.dwg
Mechanical Drawings/DPLX_P030_VIPE Insulation Bottom.dwg
Mechanical Drawings/DPLX_P023_Spark Gap Shielding Bottom.dwg
Mechanical Drawings/DPLX_P032_VIPE Insulation Middle.dwg
Mechanical Drawings/DPLX_P034_VIPE Viton Insualtion.dwg
Mechanical Drawings/DPLX_P026_VIPE _Transformer-1.dwg
Mechanical Drawings/DPLX_P031_VIPE Insulation Top.dwg
CAD Step Files/DPLX_A006_RPi3.stp
Mechanical Drawings/DPLX_P019_Camera Shroud_RevA-1.dwg
Mechanical Drawings/DPLX_P001_Electrode.dwg
Mechanical Drawings/DPLX_P034_RPS VIPE Insualtion-1.dwg
Mechanical Drawings/DPLX_P014_Lab_Baseplate_Small_PV.dwg
Mechanical Drawings/DPLX_P020_Camera Shroud Base_RevB.dwg
CAD Step Files/DPLX_P022 Spark Gap Shielding Top.stp
Mechanical Drawings/DPLX_P025_Quartz_Tube.dwg
Mechanical Drawings/DPLX_P004_revD_large_outside_baffle.dwg
CAD Step Files/DPLX_P004_revD_large_outside_baffle.stp
CAD Step Files/DPLX_P003_revC_small_inside_baffle.stp
CAD Step Files/DPLX_P001_Electrode.stp
CAD Step Files/DPLX_P024_Ocean Optics Flame.stp
CAD Step Files/DPLX_P003_revB_small_inside_baffle.STEP
CAD Step Files/91771A085_18-8 SS FLAT HEAD PHILLIPS MACHINE SCREW 2-56 .875in.stp
CAD Step Files/91771A267_18-8 SS FLAT HEAD PHILLIPS MACHINE SCREW.stp
CAD Step Files/91772A113_18-8 SS PAN HEAD PHILLIPS MACHINE SCREW.stp
CAD Step Files/91828A211_TYPE 18-8 STAINLESS STEEL HEX NUT.stp
CAD Step Files/92000A128_18-8 SS METRIC PAN HEAD PHIL MACHINE SCREW M3 20mm.stp
CAD Step Files/92010A122_METRIC 18-8 SS FLAT HEAD PHIL MACHINE SCREW.stp
CAD Step Files/92010A787_PASSIVATED 18-8 SS PHILLIPS FLAT HEAD SCREW.stp
CAD Step Files/9429T360_STEEL CLAMP.stp
CAD Step Files/9434T170_STEEL CLAMP WITH ONE MOUNTING HOLE.stp
CAD Step Files/DPLX_P006_BRASS SOCKET HEAD CAP SCREW.STEP
CAD Step Files/DPLX_P006_BRASS SOCKET HEAD CAP SCREW.stp
CAD Step Files/DPLX_P020_Camera Shroud Base_RevA.stp
CAD Step Files/No 2 Screw^225-00000-000_CD.stp
Mechanical Drawings/DPLX_P006_BRASS SOCKET HEAD CAP SCREW-1.dwg
Mechanical Drawings/DPLX_P024_Ocean Optics Flame.iam
Mechanical Drawings/OldVersions/DPLX_P003_revB_small_inside_baffle.0001.dwg
Mechanical Drawings/OldVersions/DPLX_P006_BRASS SOCKET HEAD CAP SCREW-1.0001.dwg
Mechanical Drawings/OldVersions/DPLX_P015_Foil_Wrap_SG.0001.dwg
Mechanical Drawings/OldVersions/DPLX_P019_Camera Shroud_RevA-1.0002.dwg
Mechanical Drawings/OldVersions/DPLX_P027_Spark Gap Shielding Bottom.0001.dwg
Mechanical Drawings/OldVersions/DPLX_P031_VIPE Insulation Top.0001.dwg
Mechanical Drawings/OldVersions/DPLX_P033_SG_Viton rubber Cover.0001.dwg
Mechanical Drawings/OldVersions/Spark Gap Shielding Bottom.0005.dwg
SPARK CAD Files/91771A267_18-8 SS FLAT HEAD PHILLIPS MACHINE SCREW.ipt
SPARK CAD Files/91772A113_18-8 SS PAN HEAD PHILLIPS MACHINE SCREW.ipt
SPARK CAD Files/91772A115_18-8 SS PAN HEAD PHILLIPS MACHINE SCREW-01.ipt
SPARK CAD Files/91772A115_18-8 SS PAN HEAD PHILLIPS MACHINE SCREW.ipt
SPARK CAD Files/91828A113_TYPE 18-8 STAINLESS STEEL HEX NUT.ipt
SPARK CAD Files/91828A211_TYPE 18-8 STAINLESS STEEL HEX NUT.ipt
SPARK CAD Files/91841A005_TYPE 18-8 STAINLESS STEEL HEX NUT.ipt
SPARK CAD Files/92000A128_18-8 SS METRIC PAN HEAD PHIL MACHINE SCREW M3 20mm.ipt
SPARK CAD Files/92010A122_METRIC 18-8 SS FLAT HEAD PHIL MACHINE SCREW.ipt
SPARK CAD Files/92010A787_PASSIVATED 18-8 SS PHILLIPS FLAT HEAD SCREW.ipt
SPARK CAD Files/9429T360_STEEL CLAMP.ipt
SPARK CAD Files/9434T170_STEEL CLAMP WITH ONE MOUNTING HOLE.ipt
SPARK CAD Files/Bench^225-00000-000_CD.ipt
SPARK CAD Files/Connector^225-00000-000_CD.ipt
SPARK CAD Files/Cover Bottom^225-00000-000_CD.ipt
SPARK CAD Files/Cover Top^225-00000-000_CD.ipt
SPARK CAD Files/DPLX_A001_revE_Electrode_assmMJS.iam
SPARK CAD Files/DPLX_A002_Lab_Version.iam
SPARK CAD Files/DPLX_A004_VIPE_Lab.iam
SPARK CAD Files/DPLX_A005_Spark_Gap_Lab.iam
SPARK CAD Files/DPLX_A006_RPi3.iam
SPARK CAD Files/DPLX_P001_Electrode.ipt
SPARK CAD Files/DPLX_P003_revB_small_inside_baffle.SLDPRT
SPARK CAD Files/DPLX_P003_revB_small_inside_baffle.STL
SPARK CAD Files/DPLX_P003_revC_small_inside_baffle.ipt
SPARK CAD Files/DPLX_P003_small_inside_baffle_RevB.ipt
SPARK CAD Files/DPLX_P004_revD_large_outside_baffle.ipt
SPARK CAD Files/DPLX_P006_BRASS SOCKET HEAD CAP SCREW.SLDPRT
SPARK CAD Files/DPLX_P006_BRASS SOCKET HEAD CAP SCREW.ipt
SPARK CAD Files/DPLX_P006_BRASS SOCKET HEAD CAP SCREW_RevB.ipt
SPARK CAD Files/DPLX_P007_Wire_Mesh_Sleeve_Spark_Gap.ipt
SPARK CAD Files/DPLX_P008_Wire_Mesh_Sleeve_Trans.ipt
SPARK CAD Files/DPLX_P009_Wire_Mesh_reducer_Trans.ipt
SPARK CAD Files/DPLX_P010_Wire_Mesh_reducer_Spark_Gap.ipt
SPARK CAD Files/DPLX_P011_Wire_Mesh_90_Elbow.ipt
SPARK CAD Files/DPLX_P012_Rubber_Insert_Transformer.ipt
SPARK CAD Files/DPLX_P013_Lab_Baseplate.ipt
SPARK CAD Files/DPLX_P014_Lab_Baseplate_Small_PV.ipt
SPARK CAD Files/DPLX_P015_Foil_Wrap_SG.ipt
SPARK CAD Files/DPLX_P016_Spark_Gap_Camera_Shroud.ipt
SPARK CAD Files/DPLX_P017_.5in _Standoff_smallplate.ipt
SPARK CAD Files/DPLX_P018_Crude_Battery_Placeholder_Smalltestmod.ipt
SPARK CAD Files/DPLX_P019_Camera Shroud_RevA.ipt
SPARK CAD Files/DPLX_P020_Camera Shroud Base_RevA.ipt
SPARK CAD Files/DPLX_P020_Camera Shroud Base_RevB.ipt
SPARK CAD Files/DPLX_P021_Standoff_Rasp_pie_Lab_payload_sv.ipt
SPARK CAD Files/DPLX_P022 Spark Gap Shielding Top.ipt
SPARK CAD Files/DPLX_P023 Spark Gap Shielding Bottom.ipt
SPARK CAD Files/DPLX_P024_Ocean Optics Flame.iam
SPARK CAD Files/DPLX_P025_Quartz_Tube.ipt
SPARK CAD Files/DPLX_P026_VIPE _Transformer.ipt
SPARK CAD Files/DPLX_P030_VIPE Insulation Bottom.ipt
SPARK CAD Files/DPLX_P031_VIPE Insulation Top.ipt
SPARK CAD Files/DPLX_P032_VIPE Insulation Middle.ipt
SPARK CAD Files/DPLX_P033_SG_Viton rubber Cover.ipt
SPARK CAD Files/DPLX_P034_RPS VIPE Viton Insualtion.ipt
SPARK CAD Files/DPLX_P035 Spark Gap Shielding Middle.ipt
SPARK CAD Files/DPLX_P036 mini USB.ipt
SPARK CAD Files/DPLX_P037 USB.ipt
SPARK CAD Files/DPLX_P038 Micro USB.ipt
SPARK CAD Files/HANRUN_HR911105A.ipt
SPARK CAD Files/MOLEX_0010897401.ipt
SPARK CAD Files/MOLEX_1040310811.ipt
SPARK CAD Files/MOLEX_672983090.ipt
SPARK CAD Files/No 2 Screw^225-00000-000_CD.ipt
SPARK CAD Files/OldVersions/Cover Top^225-00000-000_CD.0001.ipt
SPARK CAD Files/OldVersions/Cover Top^225-00000-000_CD.0002.ipt
SPARK CAD Files/OldVersions/DPLX_A001_revE_Electrode_assmMJS.0005.iam
SPARK CAD Files/OldVersions/DPLX_A002_Lab_Version.0002.iam
SPARK CAD Files/OldVersions/DPLX_A003_Lab_Version_Small_PV.0004.iam
SPARK CAD Files/OldVersions/DPLX_A003_Lab_Version_Small_RevB.0016.iam
SPARK CAD Files/OldVersions/DPLX_A004_VIPE_Lab.0003.iam
SPARK CAD Files/OldVersions/DPLX_A005_Spark_Gap_Lab.0006.iam
SPARK CAD Files/OldVersions/DPLX_P001_Electrode.0001.ipt
SPARK CAD Files/OldVersions/DPLX_P004_revD_large_outside_baffle.0002.ipt
SPARK CAD Files/OldVersions/DPLX_P006_BRASS SOCKET HEAD CAP SCREW.0002.ipt
SPARK CAD Files/OldVersions/DPLX_P007_Wire_Mesh_Sleeve_Spark_Gap.0001.ipt
SPARK CAD Files/OldVersions/DPLX_P007_Wire_Mesh_Sleeve_Spark_Gap.0002.ipt
SPARK CAD Files/OldVersions/DPLX_P008_Wire_Mesh_Sleeve_Trans.0003.ipt
SPARK CAD Files/OldVersions/DPLX_P008_Wire_Mesh_Sleeve_Trans.0004.ipt
SPARK CAD Files/OldVersions/DPLX_P009_Wire_Mesh_reducer_Trans.0002.ipt
SPARK CAD Files/OldVersions/DPLX_P010_Wire_Mesh_reducer_Spark_Gap.0002.ipt
SPARK CAD Files/OldVersions/DPLX_P010_Wire_Mesh_reducer_Spark_Gap.0004.ipt
SPARK CAD Files/OldVersions/DPLX_P012_Rubber_Insert_Transformer.0001.ipt
SPARK CAD Files/OldVersions/DPLX_P013_Lab_Baseplate.0001.ipt
SPARK CAD Files/OldVersions/DPLX_P014_Lab_Baseplate_Small_PV-1.0001.dwg
SPARK CAD Files/OldVersions/DPLX_P014_Lab_Baseplate_Small_PV.0006.ipt
SPARK CAD Files/OldVersions/DPLX_P016_Spark_Gap_Camera_Shroud.0001.ipt
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
