mschwabmd/UMBC_DPLX_SPARK_2018/Assembly Instructions/SPARK_Binder_Spine_Insert.docx

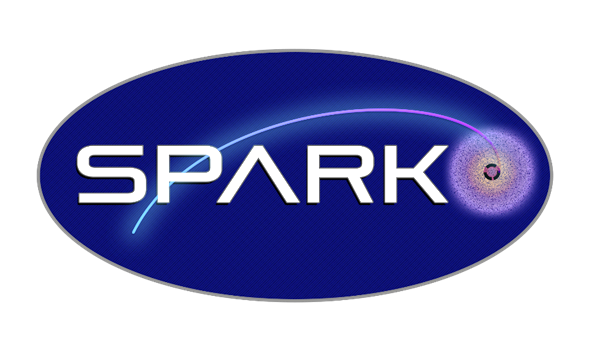
[picture p75: figure]

SPARK Device

ROCKSAT-XN 2019
