mschwabmd/UMBC_DPLX_SPARK_2018/Assembly Instructions/ROCKSAT_XN Lab Manual Cover Page.docx

ROCKSAT-XN 2019

SPARK Device

User Manual

University of Maryland, Baltimore County

Dusty Plasma Laboratory

In Collaboration With

Capital Technology University

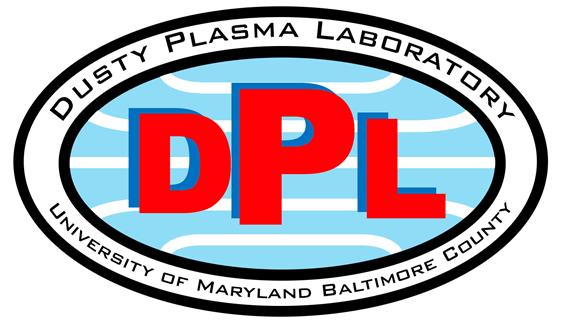
[picture p76: figure]
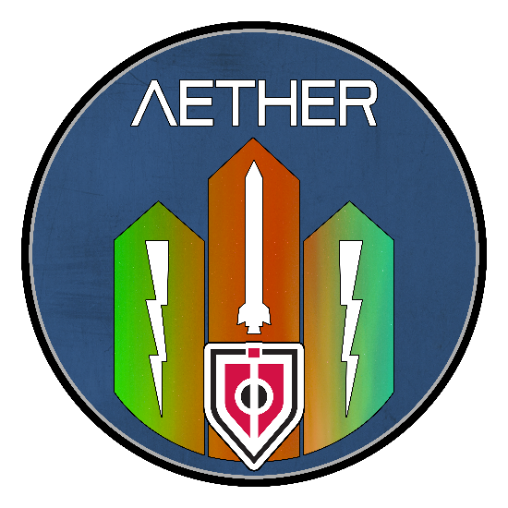
[picture p77: figure]
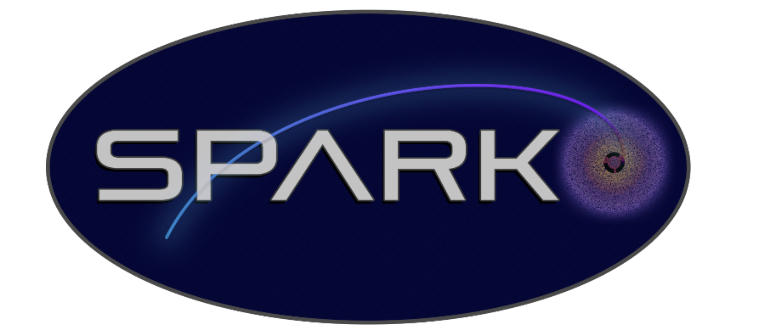
[picture p78: figure]
