mschwabmd/UMBC_DPLX_SPARK_2018/Assembly Instructions/ROCKSAT_XN Flight Model Manual Cover Page.docx

ROCKSAT-XN 2019

Spark Gap

Flight Model

User Manual

University of Maryland, Baltimore County

In Collaboration With

Capital Technology University

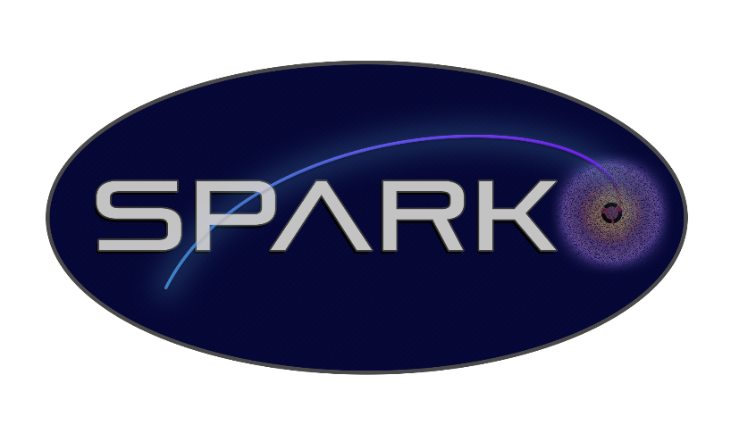
[picture p116: figure]
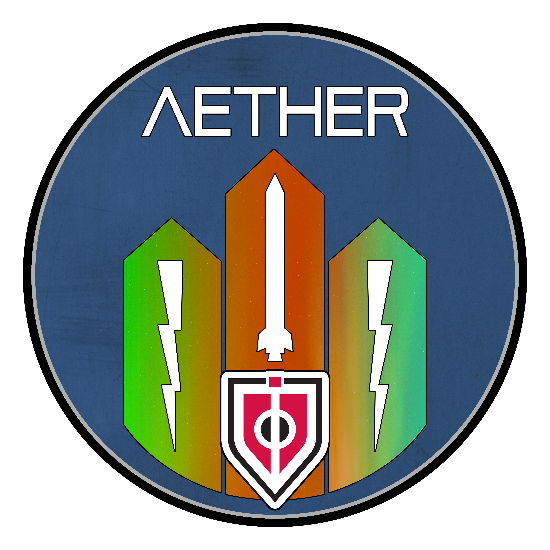
[picture p117: figure]
