mschwabmd/UMBC_DPLX_SPARK_2018/Mechanical Drawings/DPLX_P006_BRASS SOCKET HEAD CAP SCREW-1.pdf

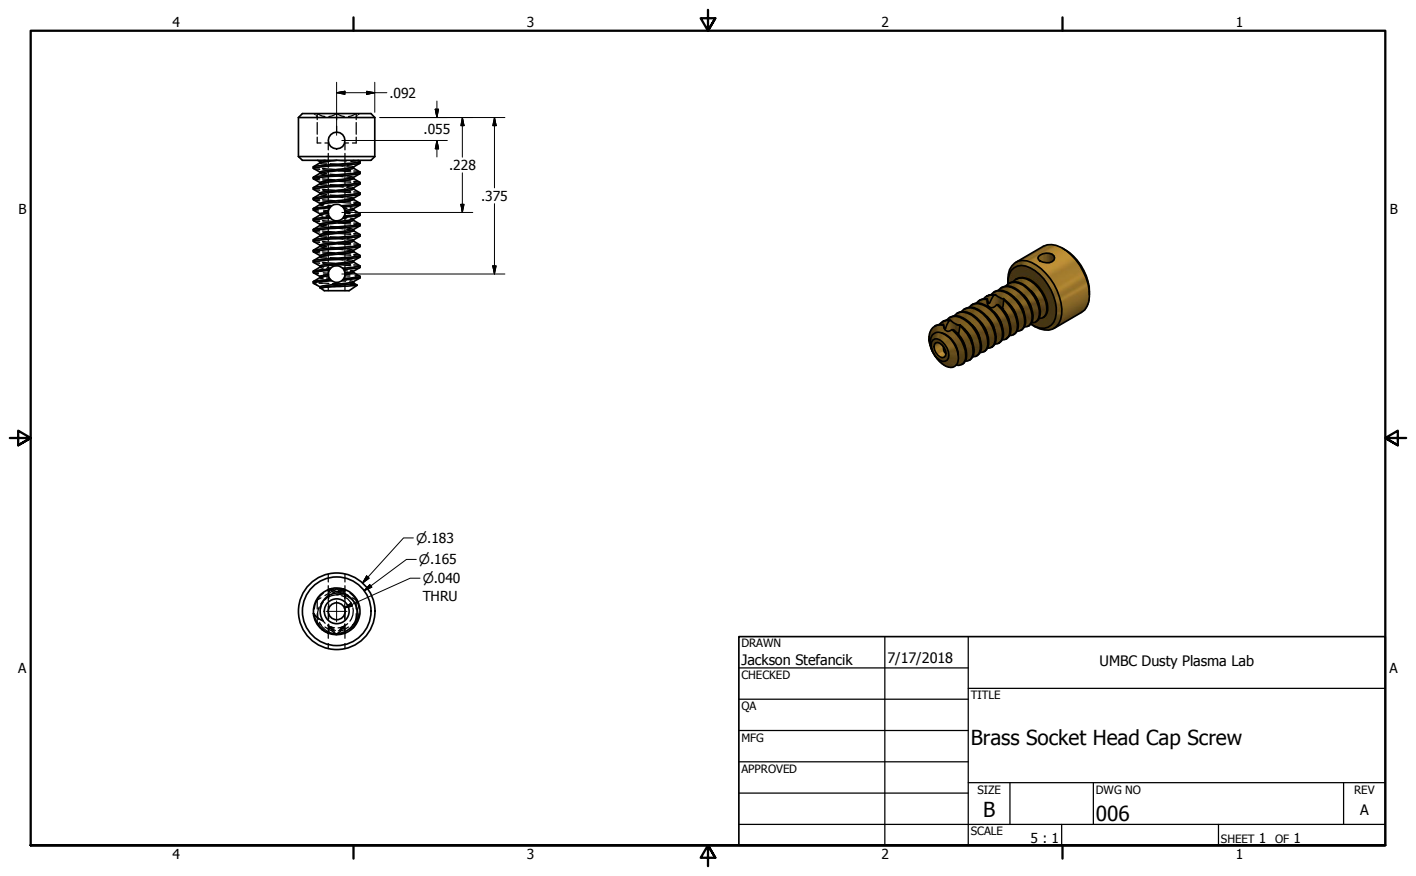
[picture p118: page 1]

DRAWN Jackson Stefancik | 7/17/2018 | UMBC Dusty Plasma Lab

CHECKED

MFG

Brass Socket Head Cap Screw

APPROVED

SIZE B | DWG NO 006 | REV A

SCALE 5 : 1 | | SHEET 1 OF 1
