mschwabmd/UMBC_DPLX_SPARK_2018/Mechanical Drawings/DPLX_P020_Camera Shroud Base_RevB.pdf

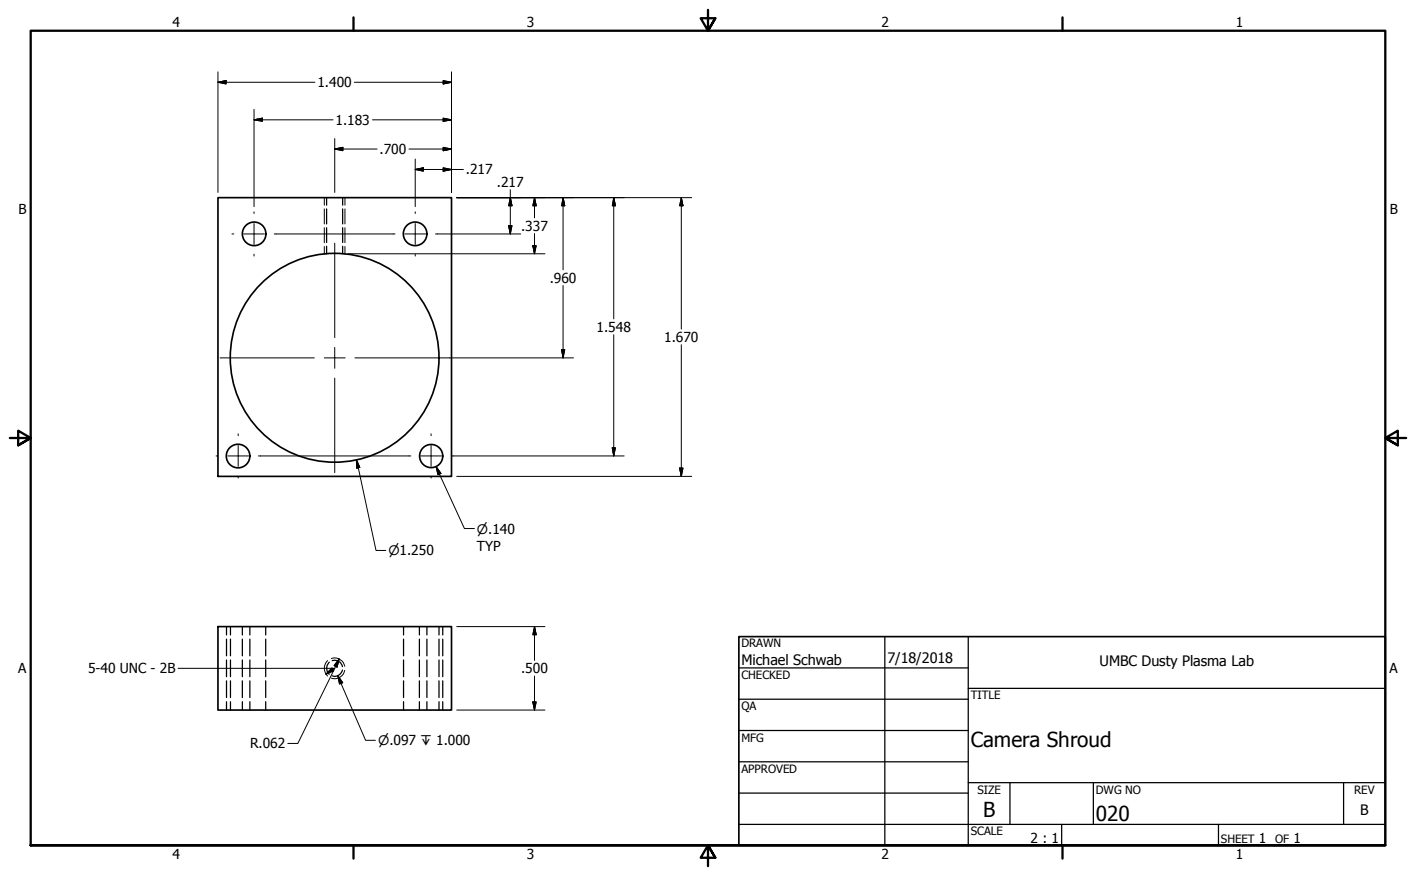
[picture p119: page 1]
Camera Shroud; 5-40 UNC - 2B

DRAWN Michael Schwab | 7/18/2018 | UMBC Dusty Plasma Lab

CHECKED

MFG

APPROVED

SIZE B | DWG NO 020 | REV B

SCALE 2 : 1 | | SHEET 1 OF 1
