mschwabmd/UMBC_DPLX_SPARK_2018/Mechanical Drawings/DPLX_P021_Standoff_Rasp_pie_Lab_payload_sv.pdf

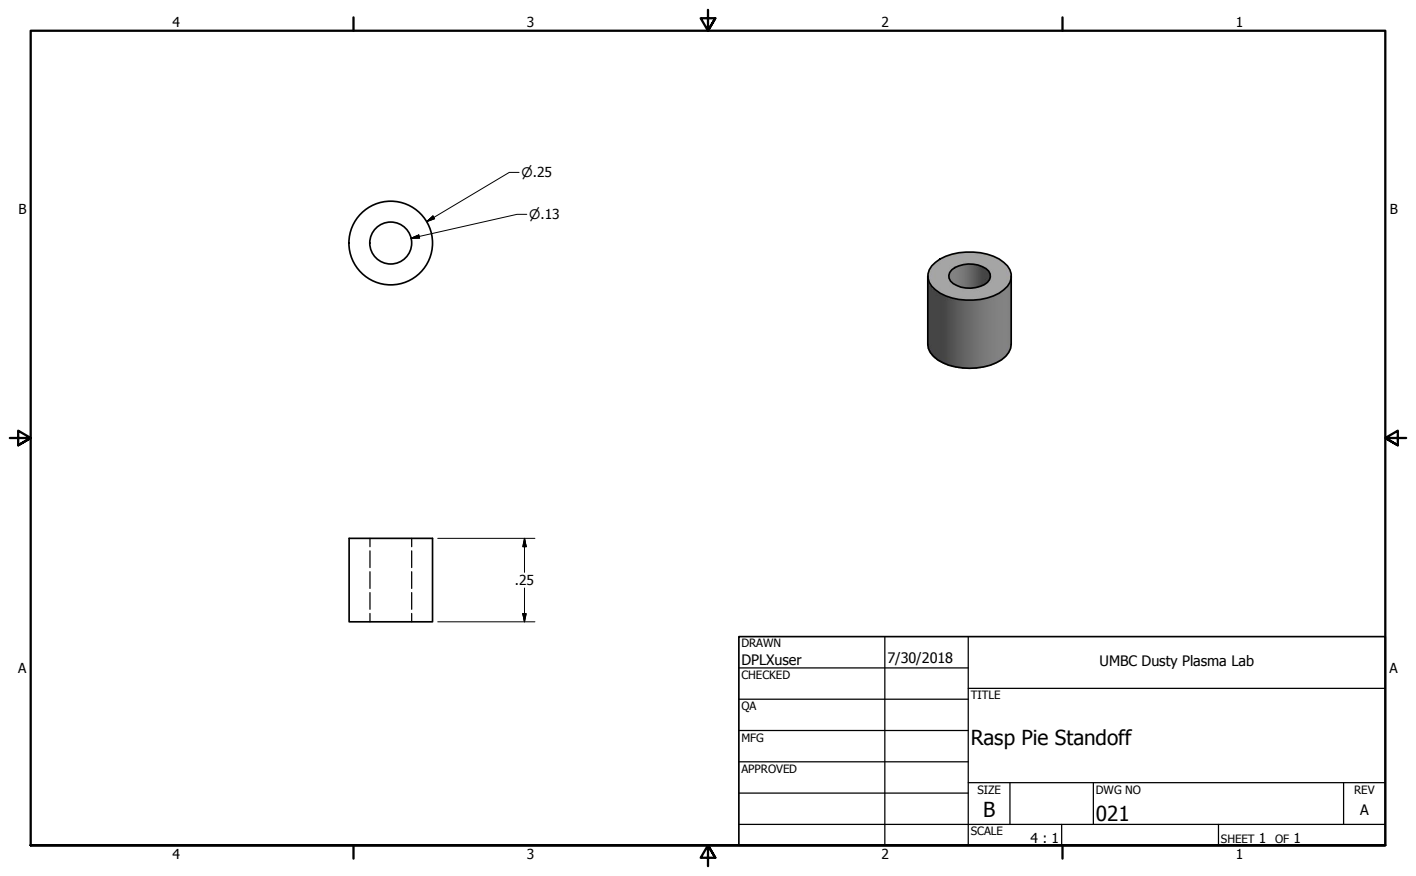
[picture p120: page 1]

DRAWN DPLXuser | 7/30/2018 | UMBC Dusty Plasma Lab

CHECKED

MFG

Rasp Pie Standoff

APPROVED

SIZE B | DWG NO 021 | REV A

SCALE 4 : 1 | | SHEET 1 OF 1
