mschwabmd/UMBC_DPLX_SPARK_2018/Mechanical Drawings/DPLX_P025_Quartz_Tube.pdf

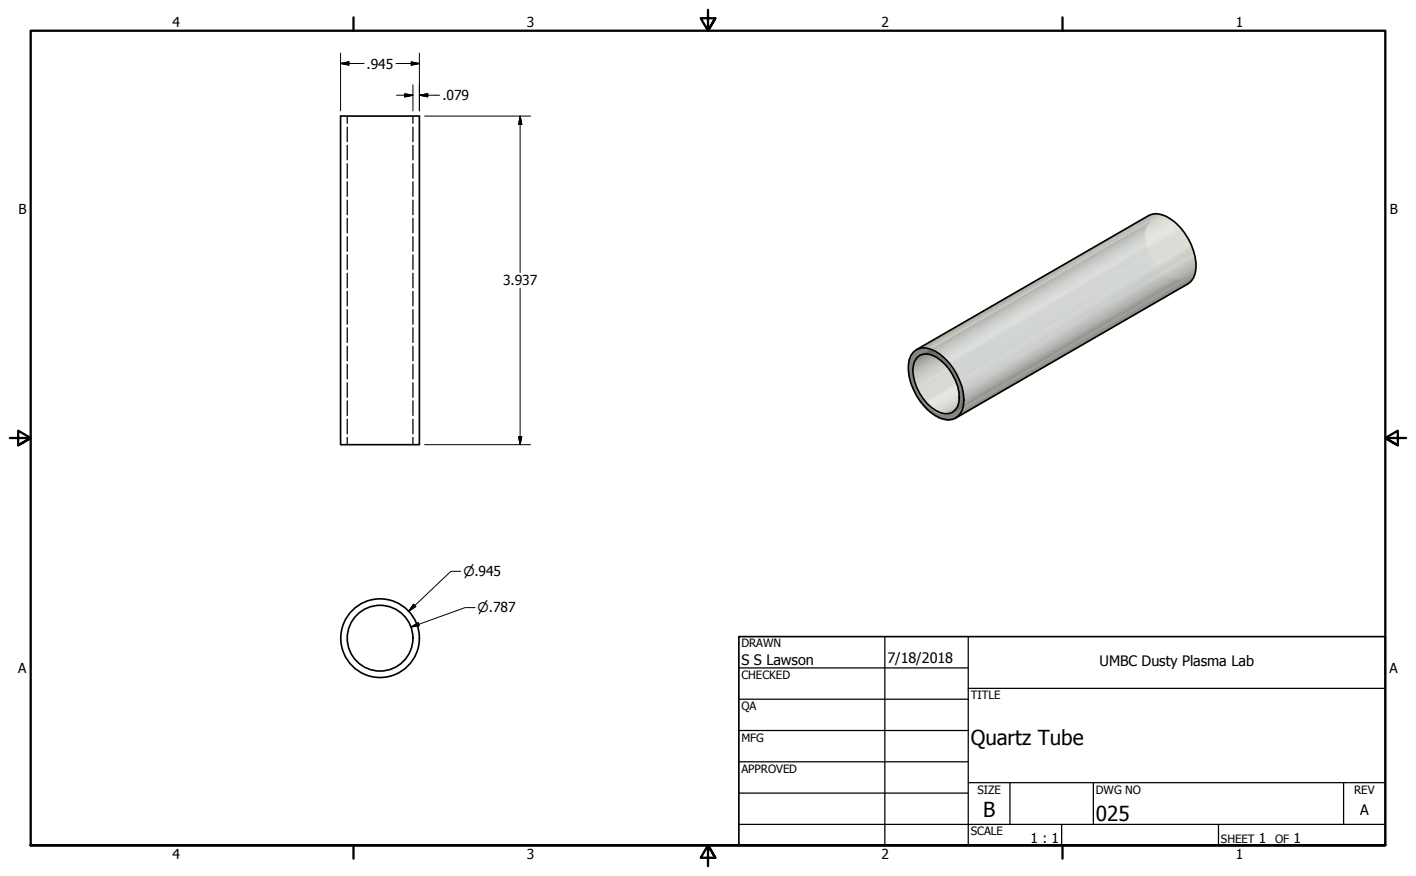
[picture p121: page 1]
Quartz Tube

DRAWN S S Lawson | 7/18/2018 | UMBC Dusty Plasma Lab

CHECKED

MFG

APPROVED

SIZE B | DWG NO 025 | REV A

SCALE 1 : 1 | | SHEET 1 OF 1
