mschwabmd/UMBC_DPLX_SPARK_2018/Mechanical Drawings/DPLX_P001_Electrode.pdf

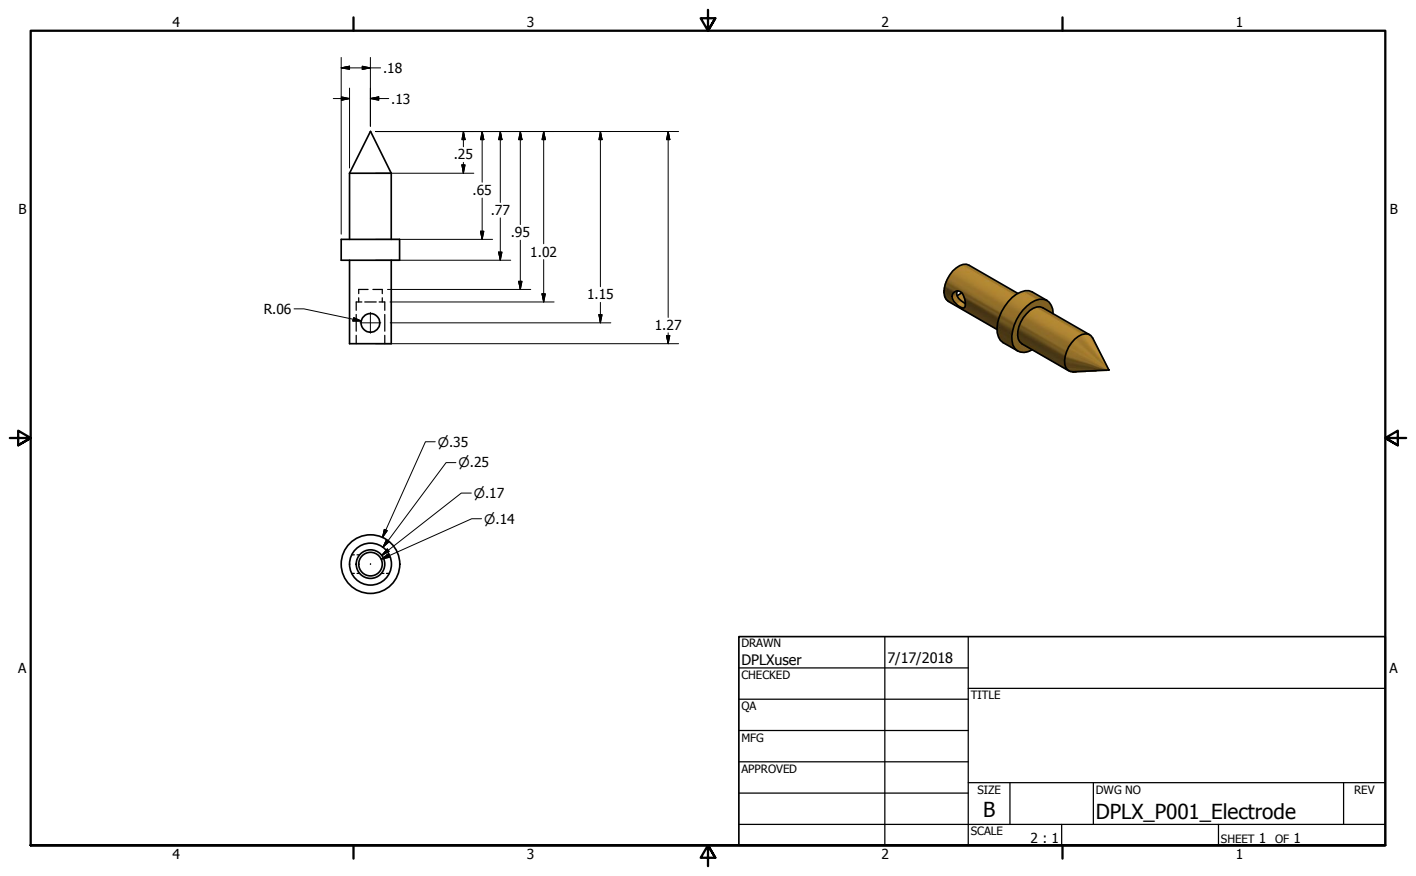
[picture p122: page 1]

DRAWN DPLXuser | 7/17/2018

CHECKED

MFG

APPROVED

SIZE B | DWG NO DPLX_P001_Electrode | REV

SCALE 2 : 1 | | SHEET 1 OF 1
