mschwabmd/UMBC_DPLX_SPARK_2018/Mechanical Drawings/DPLX_P003_revB_small_inside_baffle.pdf

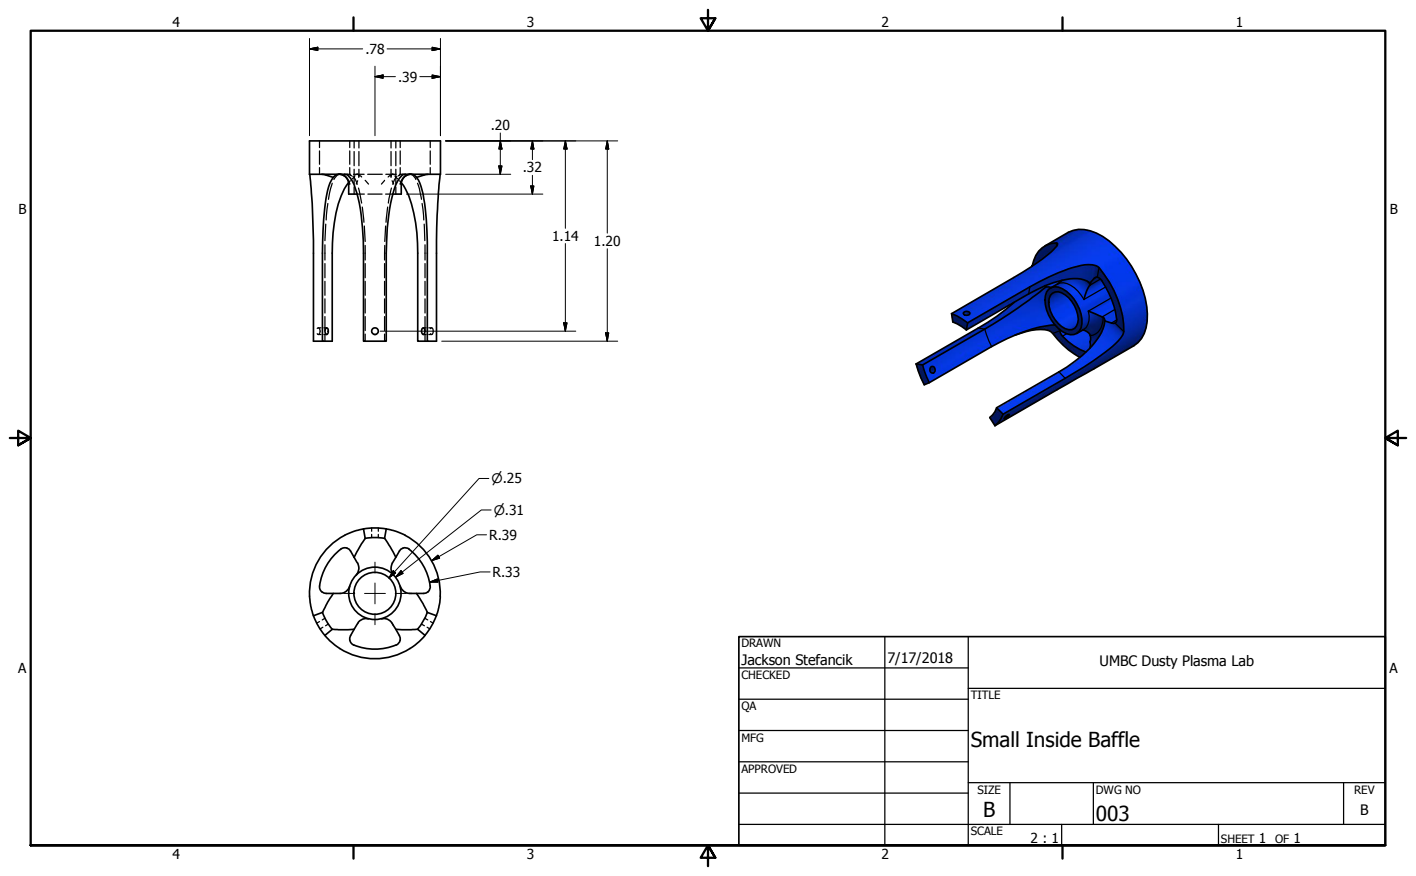
[picture p123: page 1]

DRAWN Jackson Stefancik | 7/17/2018 | UMBC Dusty Plasma Lab

CHECKED

MFG

Small Inside Baffle

APPROVED

SIZE B | DWG NO 003 | REV B

SCALE 2 : 1 | | SHEET 1 OF 1
