mschwabmd/UMBC_DPLX_SPARK_2018/Mechanical Drawings/DPLX_P004_revD_large_outside_baffle.pdf

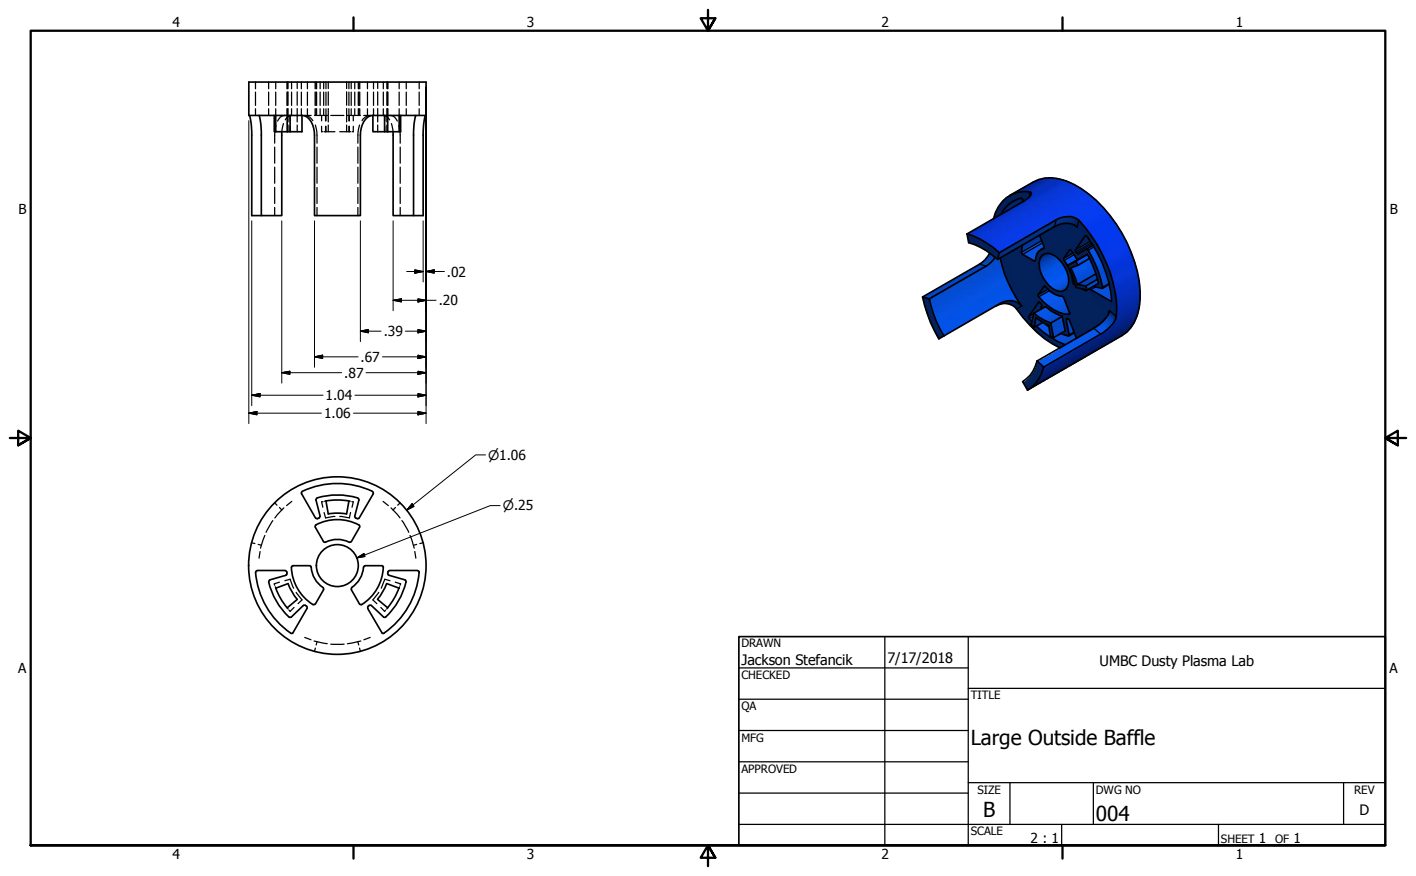
[picture p124: page 1]

DRAWN Jackson Stefancik | 7/17/2018 | UMBC Dusty Plasma Lab

CHECKED

MFG

Large Outside Baffle

APPROVED

SIZE B | DWG NO 004 | REV D

SCALE 2 : 1 | | SHEET 1 OF 1
