mschwabmd/UMBC_DPLX_SPARK_2018/Mechanical Drawings/DPLX_P014_Lab_Baseplate_Small_PV.pdf

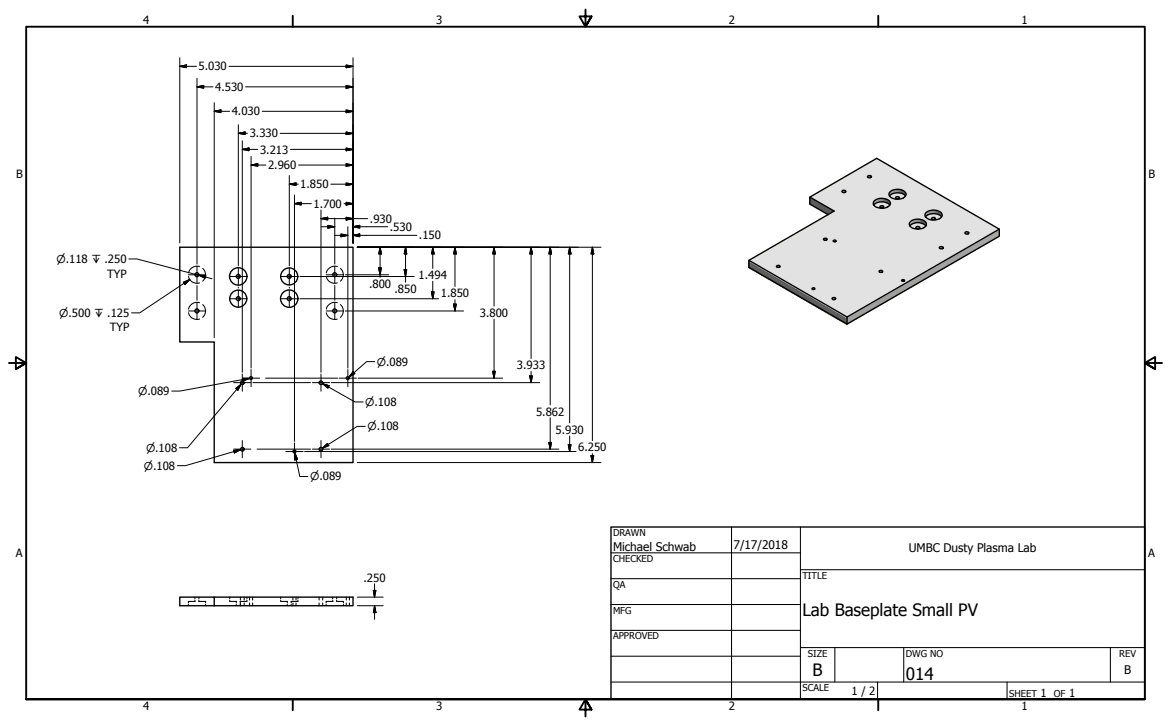
[picture p125: page 1]

DRAWN Michael Schwab | 7/17/2018 | UMBC Dusty Plasma Lab

CHECKED

MFG

Lab Baseplate Small PV

APPROVED

SIZE B | DWG NO 014 | REV B

SCALE 1 / 2 | | SHEET 1 OF 1
