mschwabmd/UMBC_DPLX_SPARK_2018/Mechanical Drawings/DPLX_P015_Foil_Wrap_SG.pdf

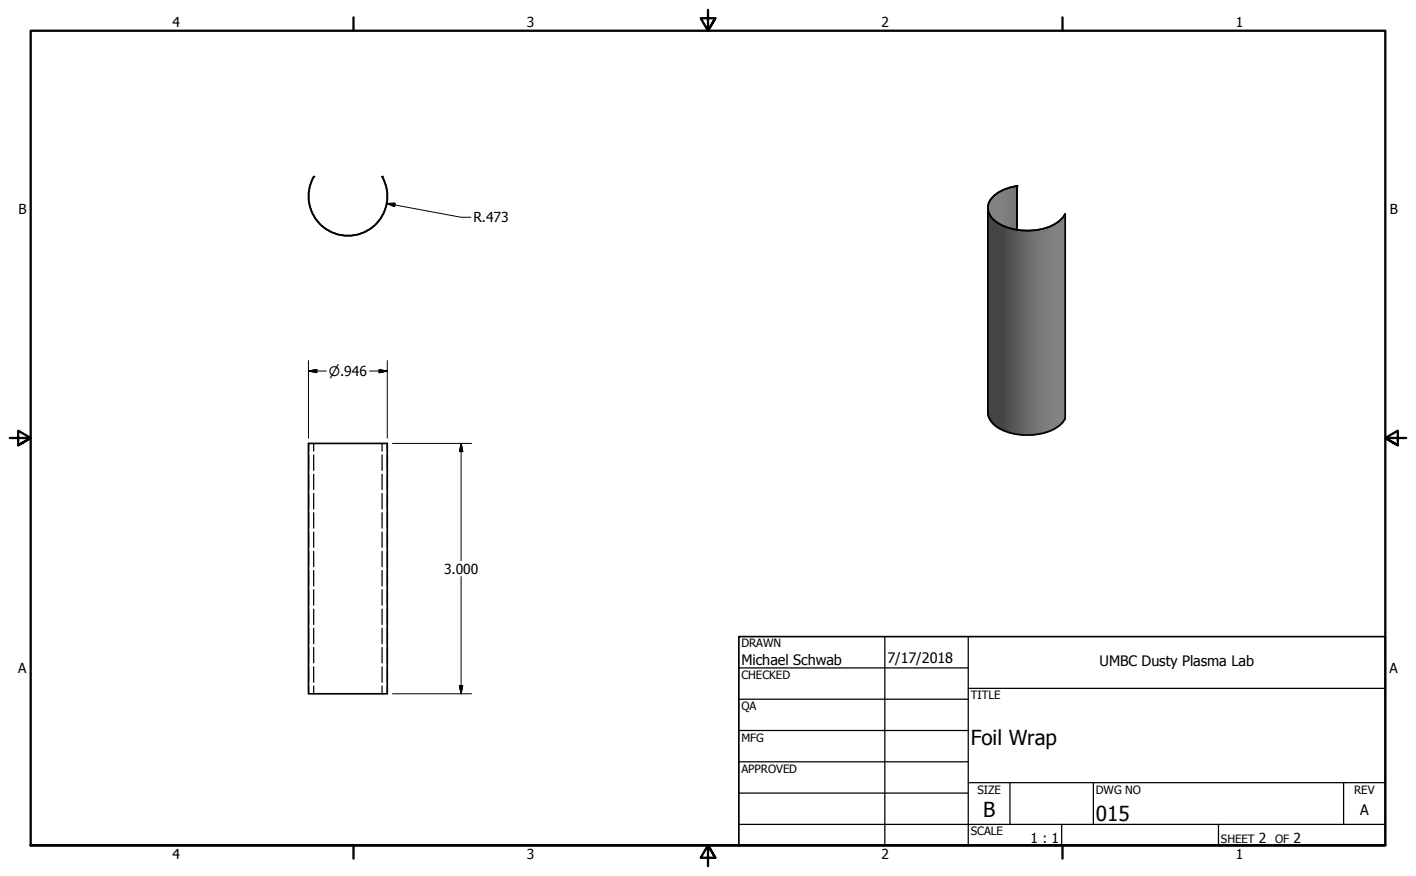
[picture p126: page 1]
Foil Wrap

DRAWN Michael Schwab | 7/17/2018 | UMBC Dusty Plasma Lab

CHECKED

MFG

APPROVED

SIZE B | DWG NO 015 | REV A

SCALE 1 : 1 | | SHEET 2 OF 2
