mschwabmd/UMBC_DPLX_SPARK_2018/Mechanical Drawings/DPLX_P019_Camera Shroud_RevA-1.pdf

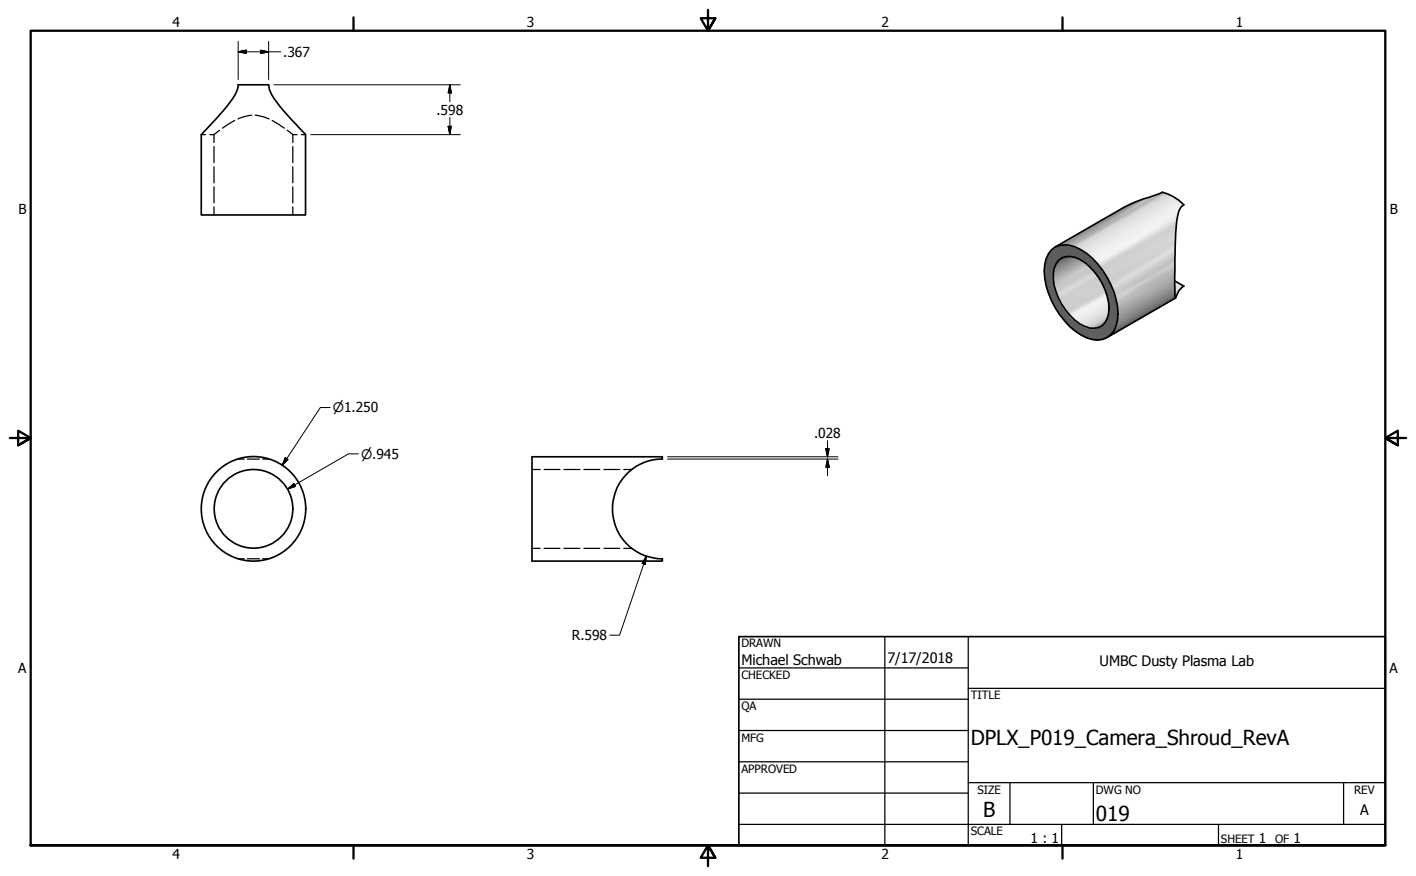
[picture p127: page 1]

DRAWN Michael Schwab | 7/17/2018 | UMBC Dusty Plasma Lab

CHECKED

MFG

APPROVED

SIZE B | DWG NO 019 | REV A

SCALE 1 : 1 | | SHEET 1 OF 1
