mschwabmd/UMBC_DPLX_SPARK_2018/Mechanical Drawings/DPLX_P022_Spark Gap Shielding Top.pdf

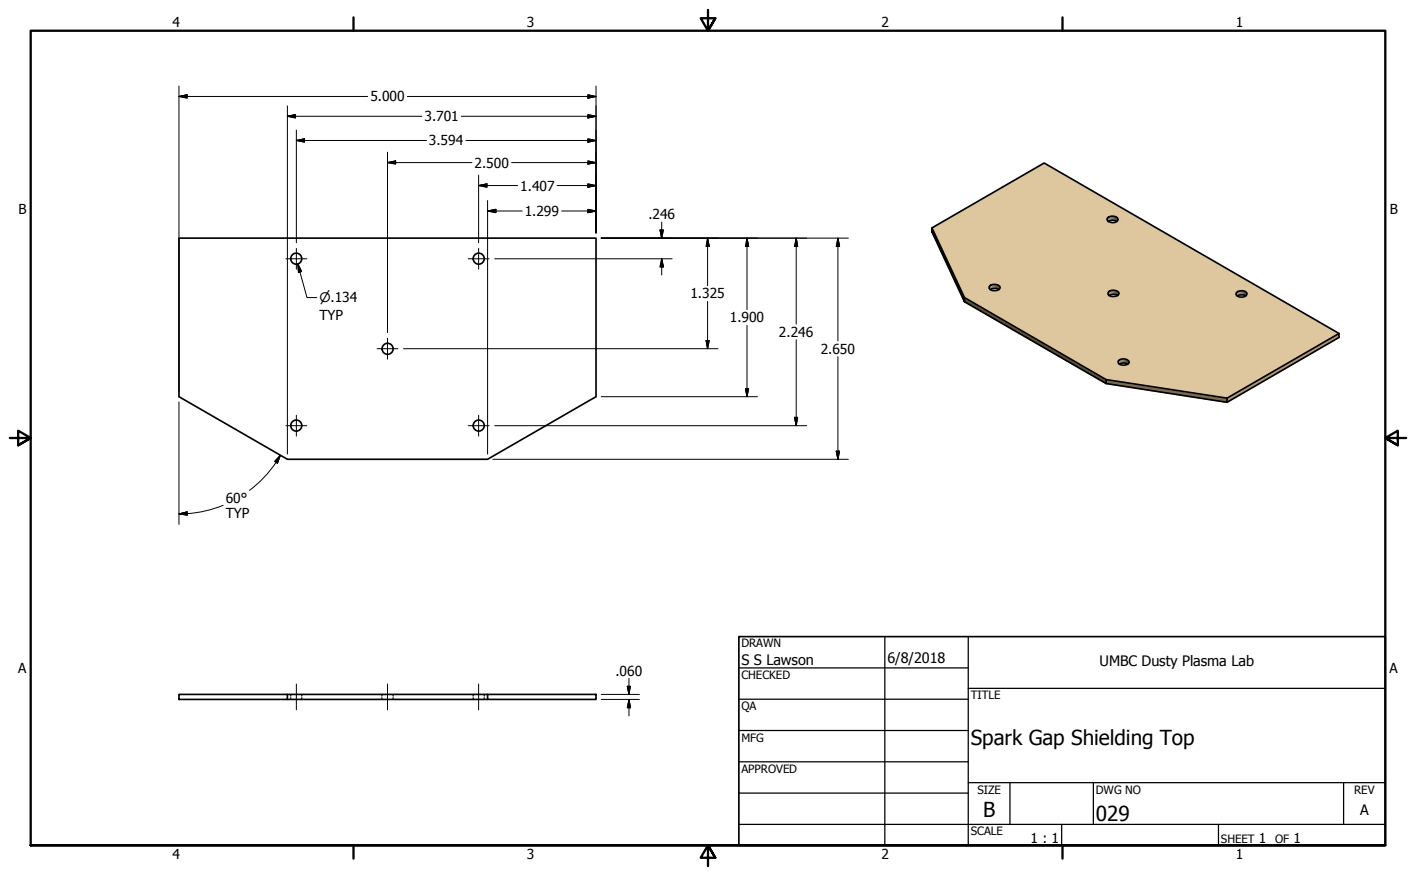
[picture p128: page 1]

DRAWN S S Lawson | 6/8/2018 | UMBC Dusty Plasma Lab

CHECKED

TITLE
Spark Gap Shielding Top

MFG

APPROVED

SIZE B | DWG NO 029 | REV A

SCALE 1 : 1 | | SHEET 1 OF 1
