mschwabmd/UMBC_DPLX_SPARK_2018/Mechanical Drawings/DPLX_P023_Spark Gap Shielding Bottom.pdf

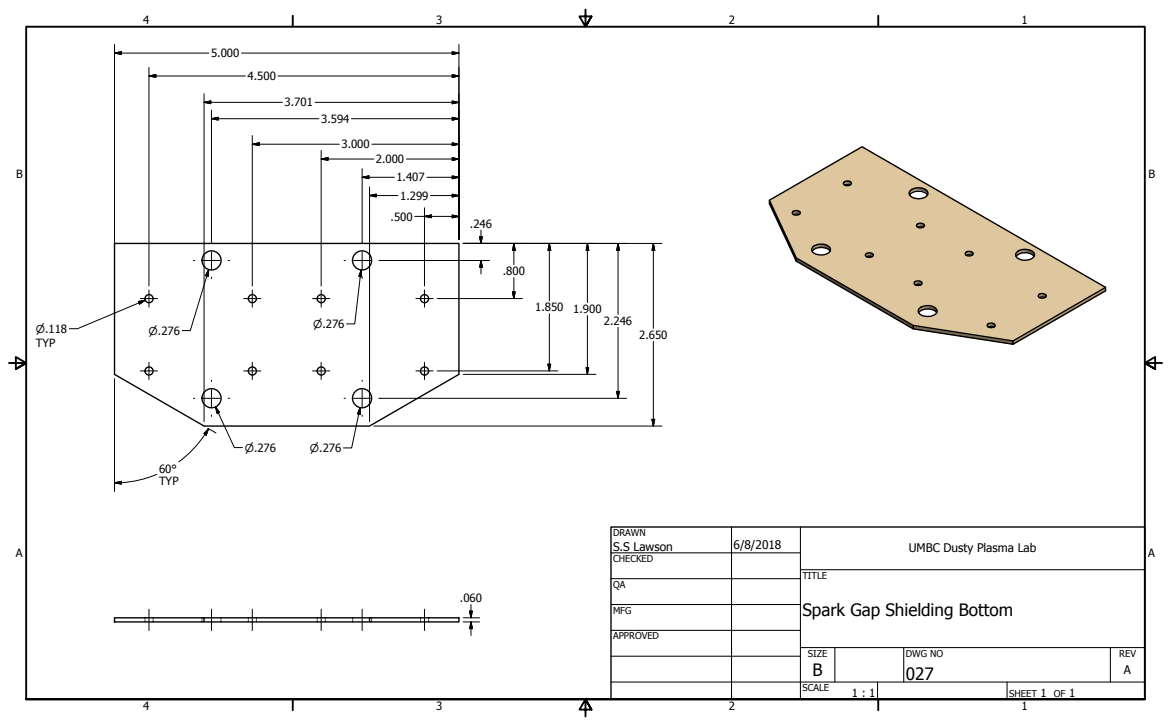
[picture p129: page 1]

DRAWN S.S Lawson | 6/8/2018 | UMBC Dusty Plasma Lab

CHECKED

TITLE
Spark Gap Shielding Bottom

MFG

APPROVED

SIZE B | DWG NO 027 | REV A

SCALE 1 : 1 | | SHEET 1 OF 1
