mschwabmd/UMBC_DPLX_SPARK_2018/Mechanical Drawings/DPLX_P026_VIPE _Transformer-1.pdf

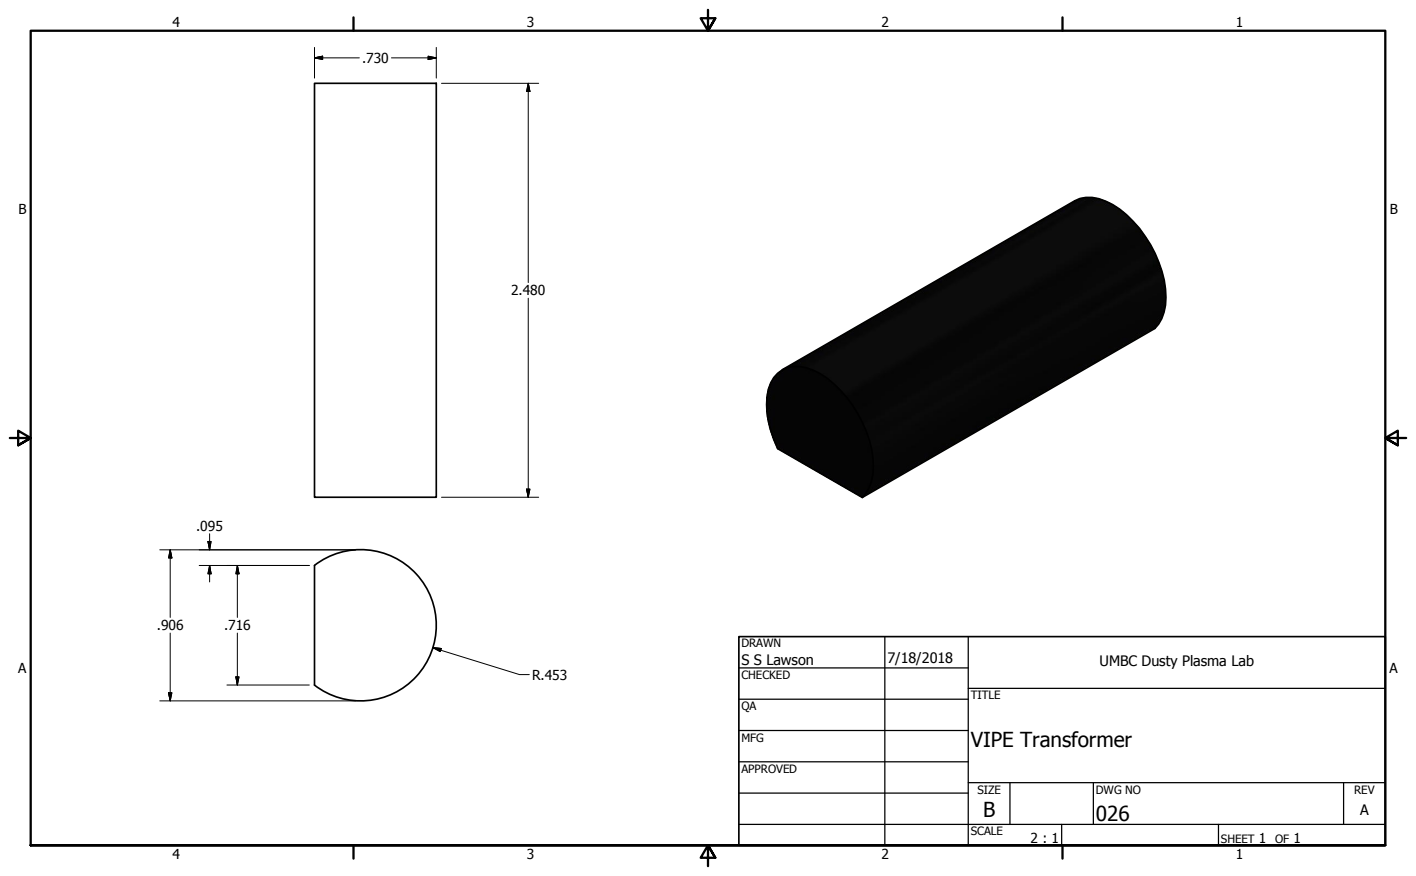
[picture p131: page 1]
VIPE Transformer

DRAWN S S Lawson | 7/18/2018 | UMBC Dusty Plasma Lab

CHECKED

MFG

APPROVED

SIZE B | DWG NO 026 | REV A

SCALE 2 : 1 | | SHEET 1 OF 1
