mschwabmd/UMBC_DPLX_SPARK_2018/Mechanical Drawings/DPLX_P030_VIPE Insulation Bottom.pdf

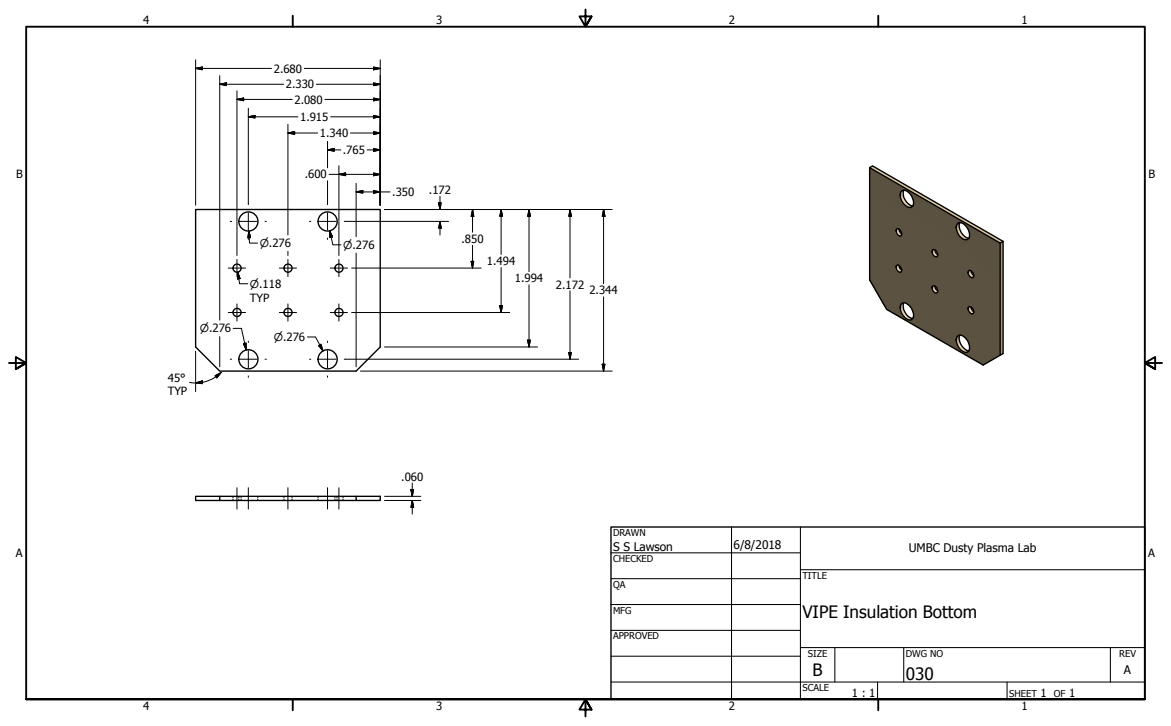
[picture p132: page 1]

DRAWN S S Lawson | 6/8/2018 | UMBC Dusty Plasma Lab

CHECKED

MFG

VIPE Insulation Bottom

APPROVED

SIZE B | DWG NO 030 | REV A

SCALE 1 : 1 | | SHEET 1 OF 1
