mschwabmd/UMBC_DPLX_SPARK_2018/Mechanical Drawings/DPLX_P031_VIPE Insulation Top.pdf

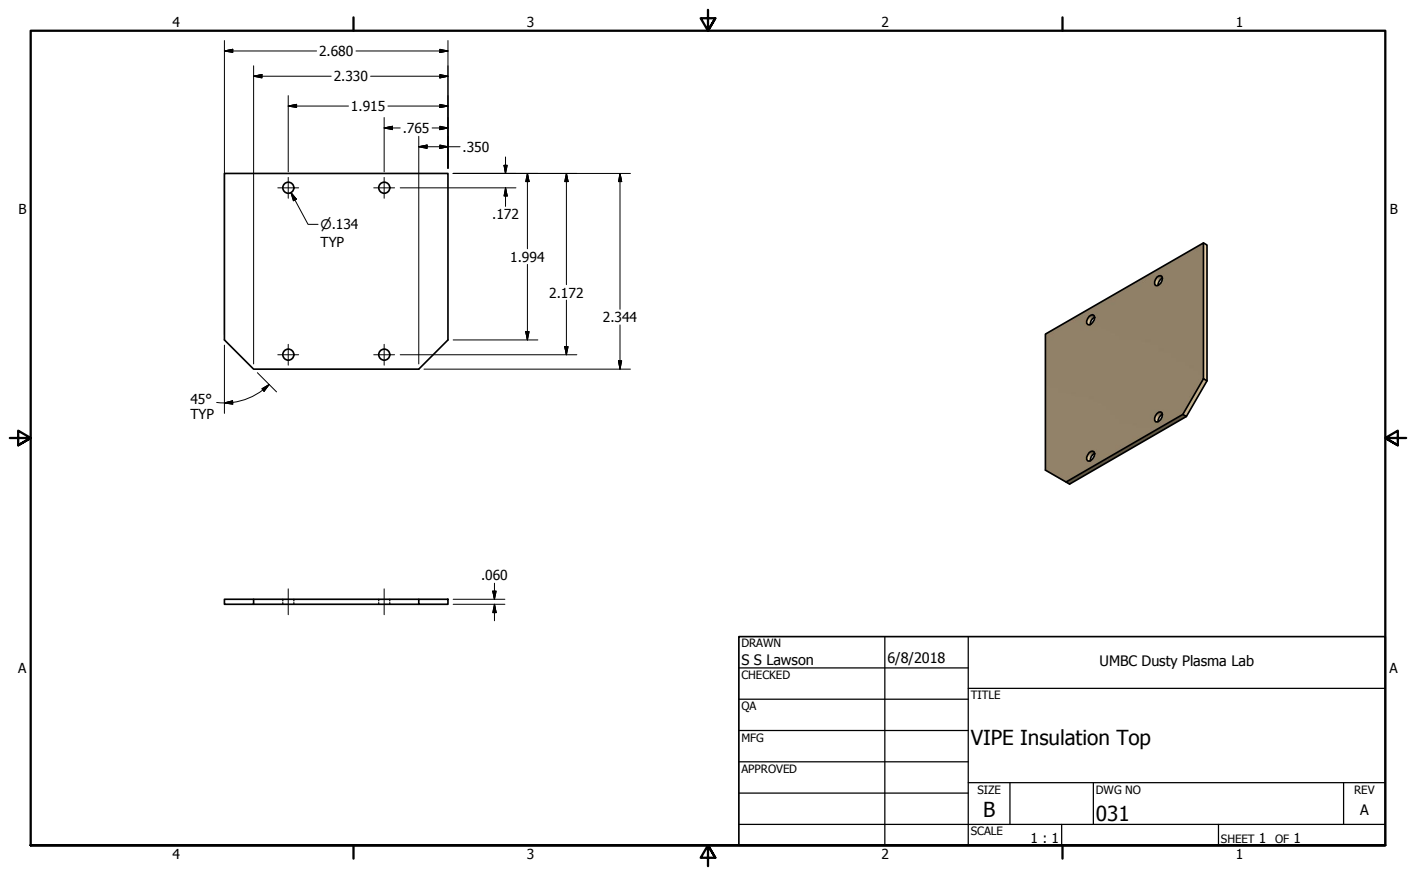
[picture p133: page 1]

DRAWN S S Lawson | 6/8/2018 | UMBC Dusty Plasma Lab

CHECKED

MFG

VIPE Insulation Top

APPROVED

SIZE B | DWG NO 031 | REV A

SCALE 1 : 1 | | SHEET 1 OF 1
