mschwabmd/UMBC_DPLX_SPARK_2018/Mechanical Drawings/DPLX_P032_VIPE Insulation Middle.pdf

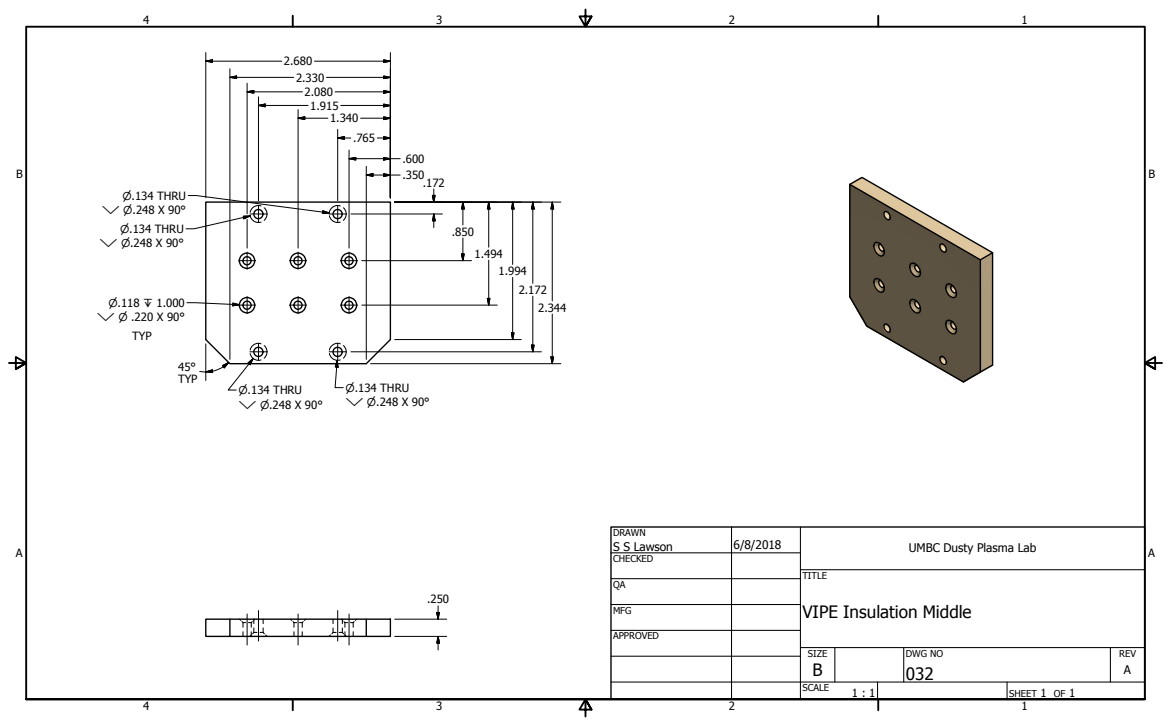
[picture p134: page 1]

DRAWN S S Lawson | 6/8/2018 | UMBC Dusty Plasma Lab

CHECKED

MFG

VIPE Insulation Middle

APPROVED

SIZE B | DWG NO 032 | REV A

SCALE 1 : 1 | | SHEET 1 OF 1
