mschwabmd/UMBC_DPLX_SPARK_2018/Mechanical Drawings/DPLX_P033_SG_Viton rubber Cover.pdf

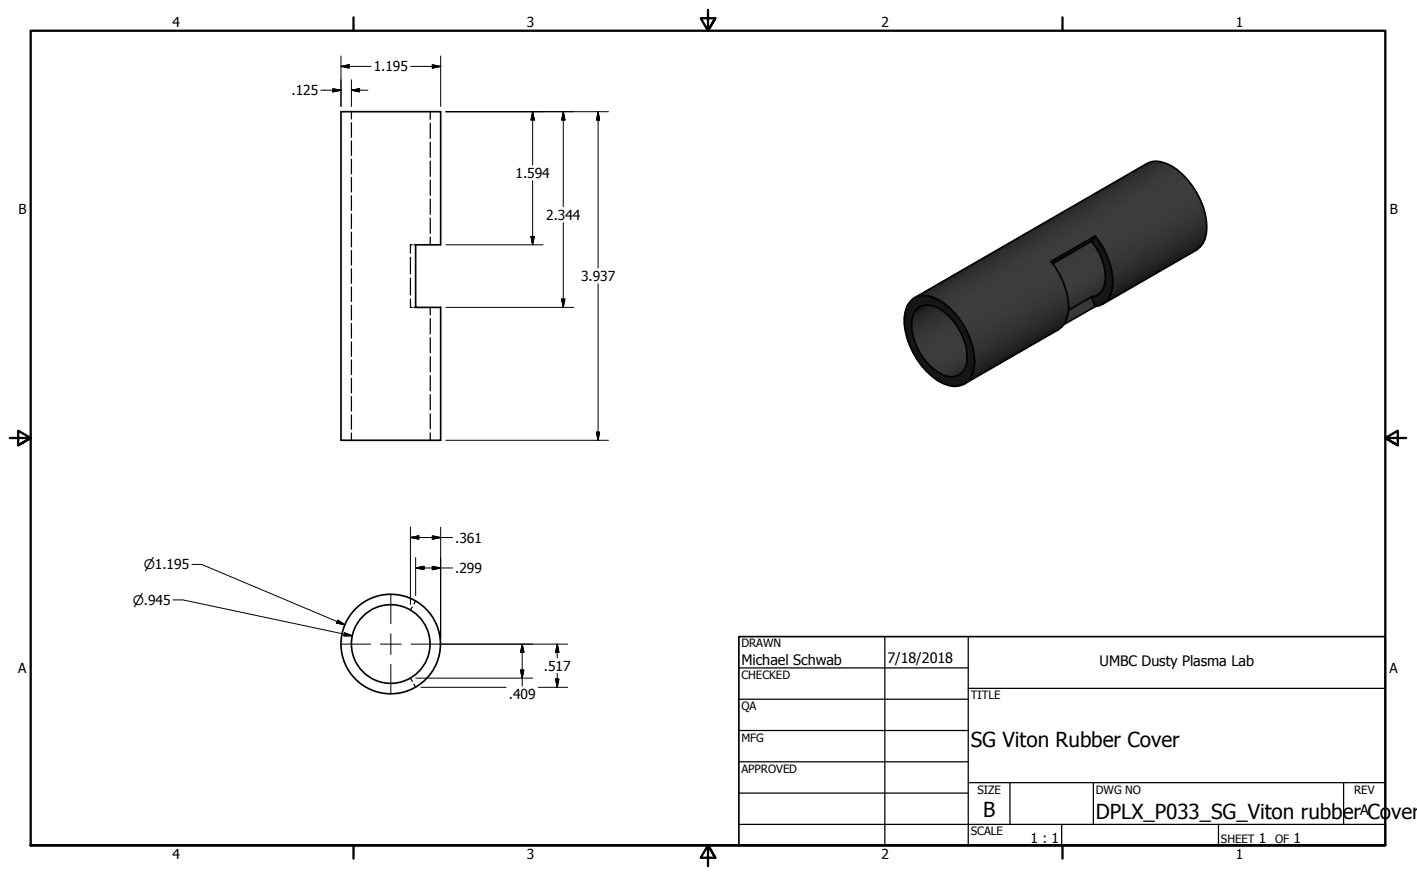
[picture p135: page 1]
DPLX_P033_SG_Viton rubber Cover

DRAWN Michael Schwab | 7/18/2018 | UMBC Dusty Plasma Lab

CHECKED

MFG

SG Viton Rubber Cover

APPROVED

SIZE B | DWG NO | REV A

SCALE 1 : 1 | | SHEET 1 OF 1
