mschwabmd/UMBC_DPLX_SPARK_2018/Mechanical Drawings/DPLX_P034_RPS VIPE Insualtion-1.pdf

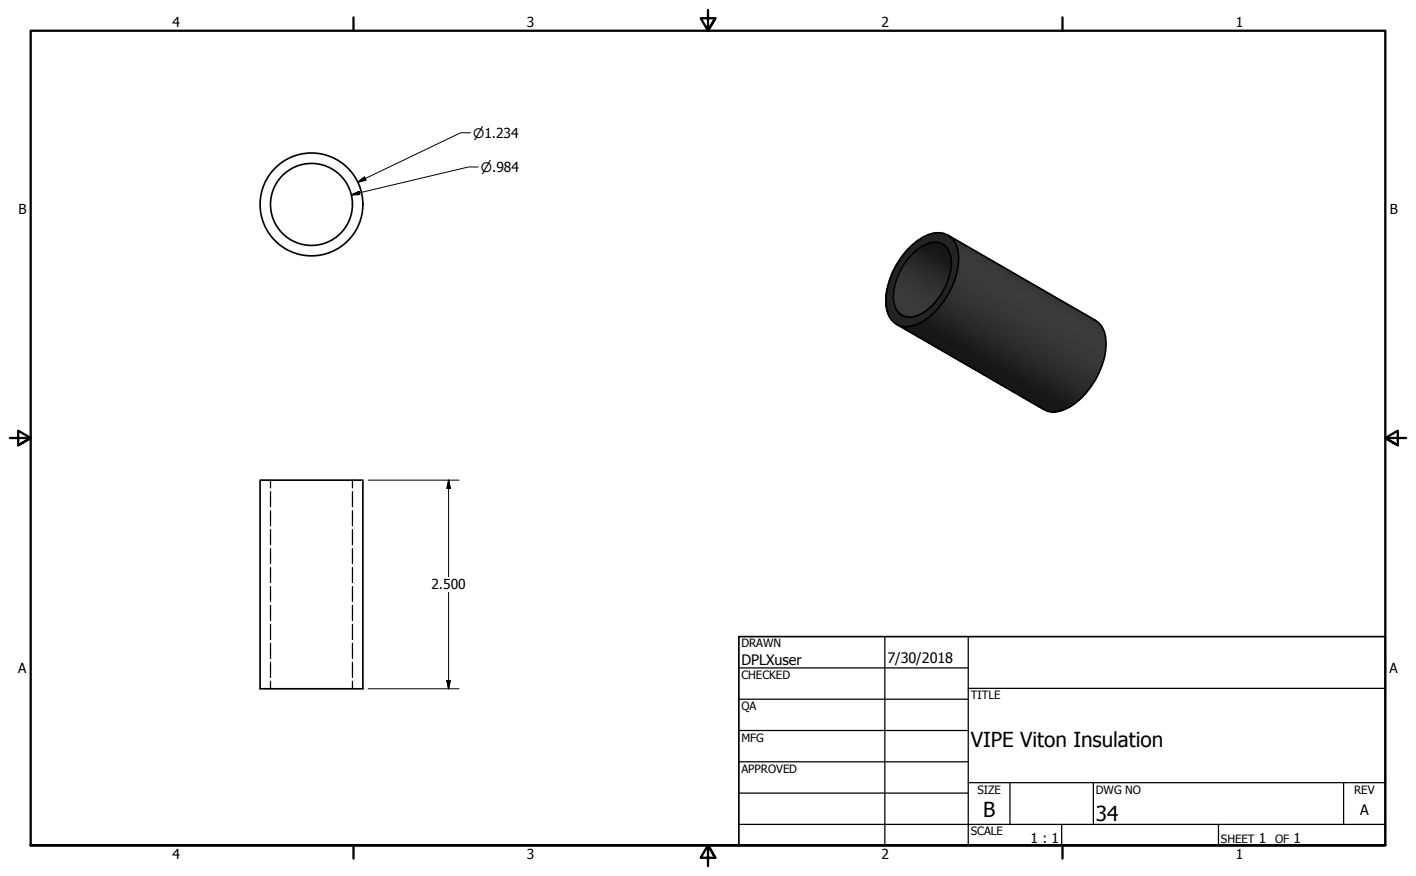
[picture p136: page 1]

DRAWN DPLXuser | 7/30/2018

CHECKED

MFG

VIPE Viton Insulation

APPROVED

SIZE B | DWG NO 34 | REV A

SCALE 1 : 1 | | SHEET 1 OF 1
