mschwabmd/UMBC_DPLX_SPARK_2018/Mechanical Drawings/DPLX_P034_VIPE Viton Insualtion.pdf

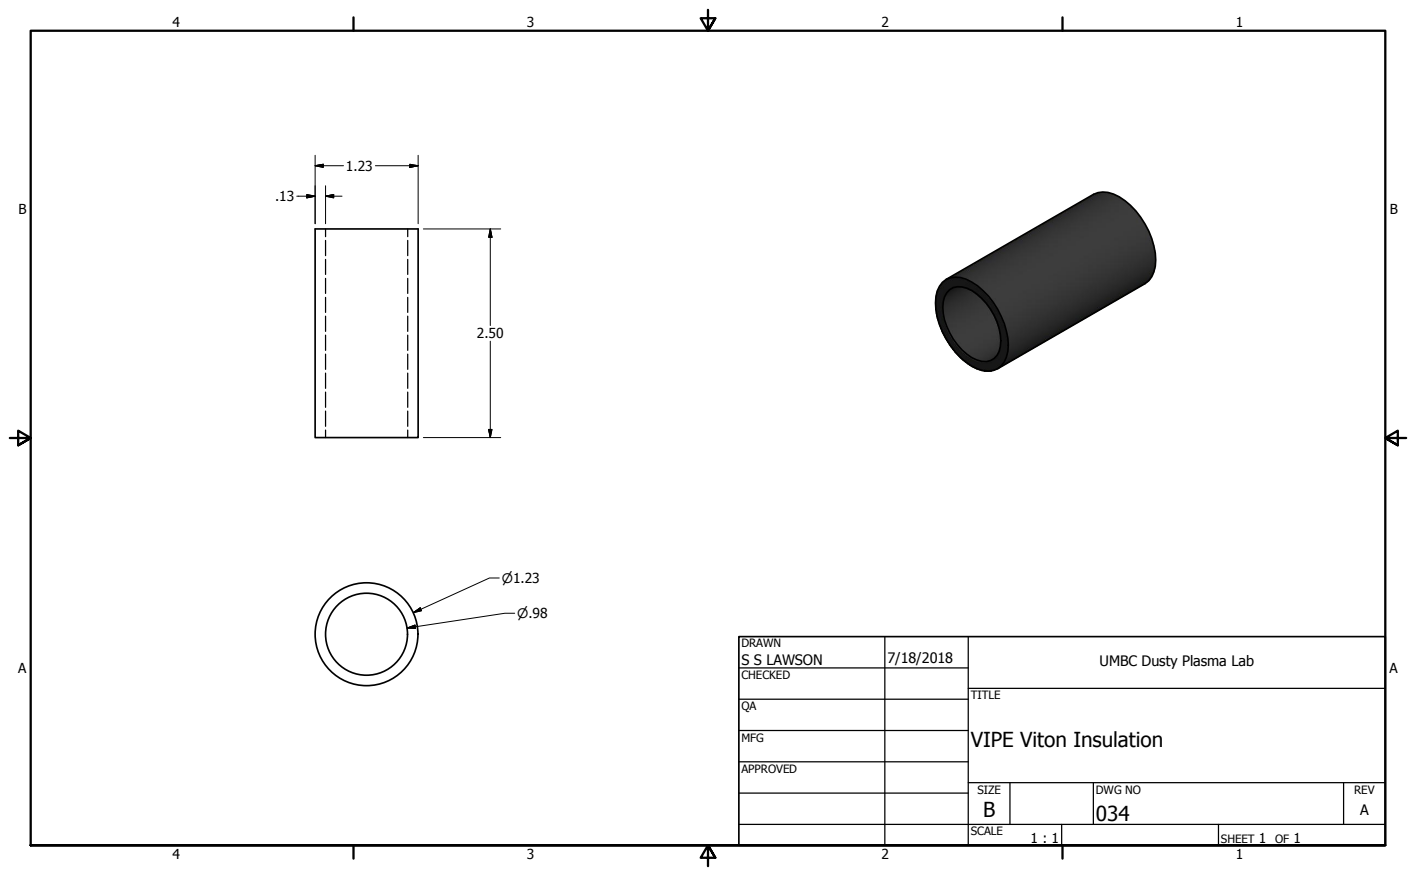
[picture p137: page 1]

DRAWN S S LAWSON | 7/18/2018 | UMBC Dusty Plasma Lab

CHECKED

MFG

VIPE Viton Insulation

APPROVED

SIZE B | DWG NO 034 | REV A

SCALE 1 : 1 | | SHEET 1 OF 1
