mschwabmd/UMBC_DPLX_SPARK_2018/Mechanical Drawings/DPLX_P035_Spark Gap Shielding Middle.pdf

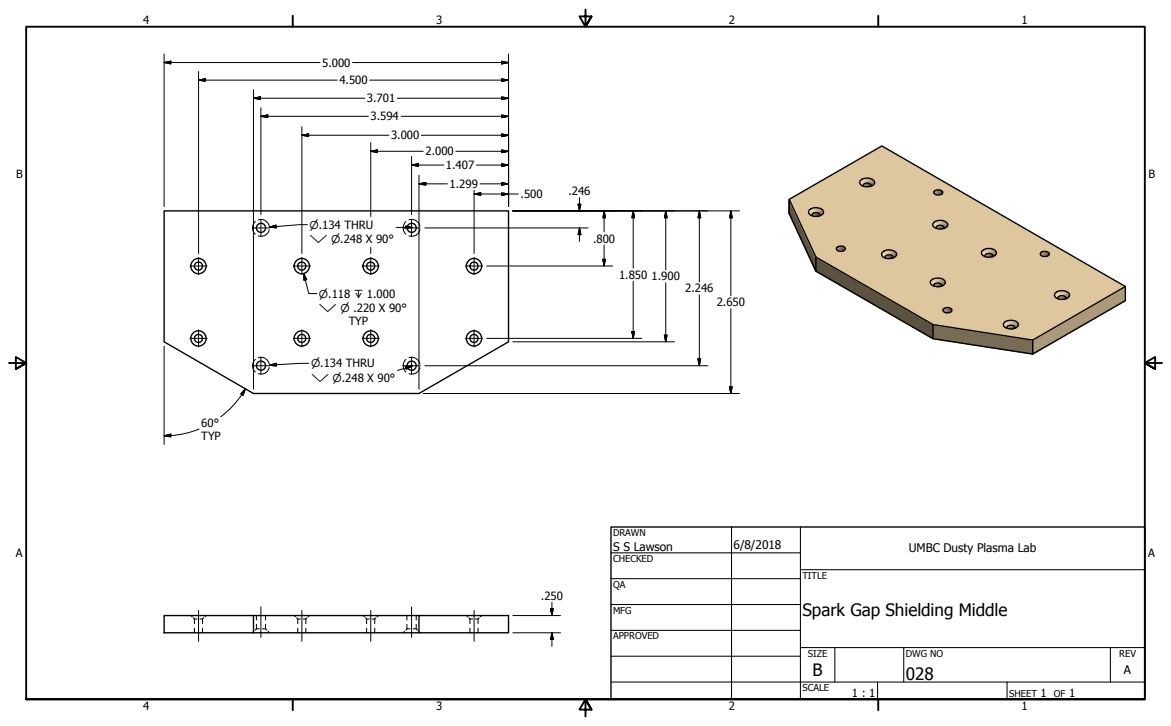
[picture p138: page 1]

DRAWN S S Lawson | 6/8/2018 | UMBC Dusty Plasma Lab

CHECKED

TITLE
Spark Gap Shielding Middle

MFG

APPROVED

SIZE B | DWG NO 028 | REV A

SCALE 1 : 1 | | SHEET 1 OF 1
