mschwabmd/UMBC_DPLX_SPARK_2018/(commit log)

2018-07-30 Cad and Drawings
    [91771A085_18-8 SS FLAT HEAD PHILLIPS MACHINE SCREW 2-56 .875in.ipt, 91771A267_18-8 SS FLAT HEAD PHILLIPS MACHINE SCREW.ipt, 91772A113_18-8 SS PAN HEAD PHILLIPS MACHINE SCREW.ipt, 91828A211_TYPE 18-8 STAINLESS STEEL HEX NUT.ipt, 92000A128_18-8 SS METRIC PAN HEAD PHIL MACHINE SCREW M3 20mm.ipt, 92010A122_METRIC 18-8 SS FLAT HEAD PHIL MACHINE SCREW.ipt, 92010A787_PASSIVATED 18-8 SS PHILLIPS FLAT HEA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]
2018-07-31 Updated Assembly Instructions and added software folder
2018-07-31 added new set screw and step files
    [DPLX_P006_BRASS SOCKET HEAD CAP SCREW.STEP, DPLX_P006_BRASS SOCKET HEAD CAP SCREW_RevB.ipt]
2018-07-31 Changed Inventor Files to STEP files
    [91771A085_18-8 SS FLAT HEAD PHILLIPS MACHINE SCREW 2-56 .875in.stp, 91771A267_18-8 SS FLAT HEAD PHILLIPS MACHINE SCREW.stp, 91772A113_18-8 SS PAN HEAD PHILLIPS MACHINE SCREW.stp, 91828A211_TYPE 18-8 STAINLESS STEEL HEX NUT.stp, 92000A128_18-8 SS METRIC PAN HEAD PHIL MACHINE SCREW M3 20mm.stp, 92010A122_METRIC 18-8 SS FLAT HEAD PHIL MACHINE SCREW.stp, 92010A787_PASSIVATED 18-8 SS PHILLIPS FLAT HEA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]
2018-08-01 Adding Pictures to Assembly Instructions
2018-08-01 Created Flight Model Assembly Instructions Draft. Still needs info filled in as well as updated pictures
2018-08-01 More Updates to the Flight Model Assembly Instructions. Still needs more picture updates.
2018-08-01 more assembly updates
2018-08-03 Fixed a couple minor errors in the Pi section of the Lab Model. All pictures in the flight model are now up to date.
2018-08-06 bunch of cad file changes
    [91771A085_18-8 SS FLAT HEAD PHILLIPS MACHINE SCREW 2-56 .875in.ipt, 91772A115_18-8 SS PAN HEAD PHILLIPS MACHINE SCREW-01.ipt, 91772A115_18-8 SS PAN HEAD PHILLIPS MACHINE SCREW.ipt, 91828A113_TYPE 18-8 STAINLESS STEEL HEX NUT.ipt, 91841A005_TYPE 18-8 STAINLESS STEEL HEX NUT.ipt, DPLX_A001_revE_Electrode_assmMJS.0004.iam, DPLX_A001_revE_Electrode_assmMJS.0005.iam, DPLX_A001_revE_Electrode_assmMJS.i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]
2018-08-06 moved cad files
    [DPLX_P014_Lab_Baseplate_Small_PV.0005.ipt, DPLX_P014_Lab_Baseplate_Small_PV.0006.ipt, DPLX_P014_Lab_Baseplate_Small_PV.ipt]
